CollinHeist/UIdaho-Team-FIRE/Final Presentation/PCB Layout.jpg

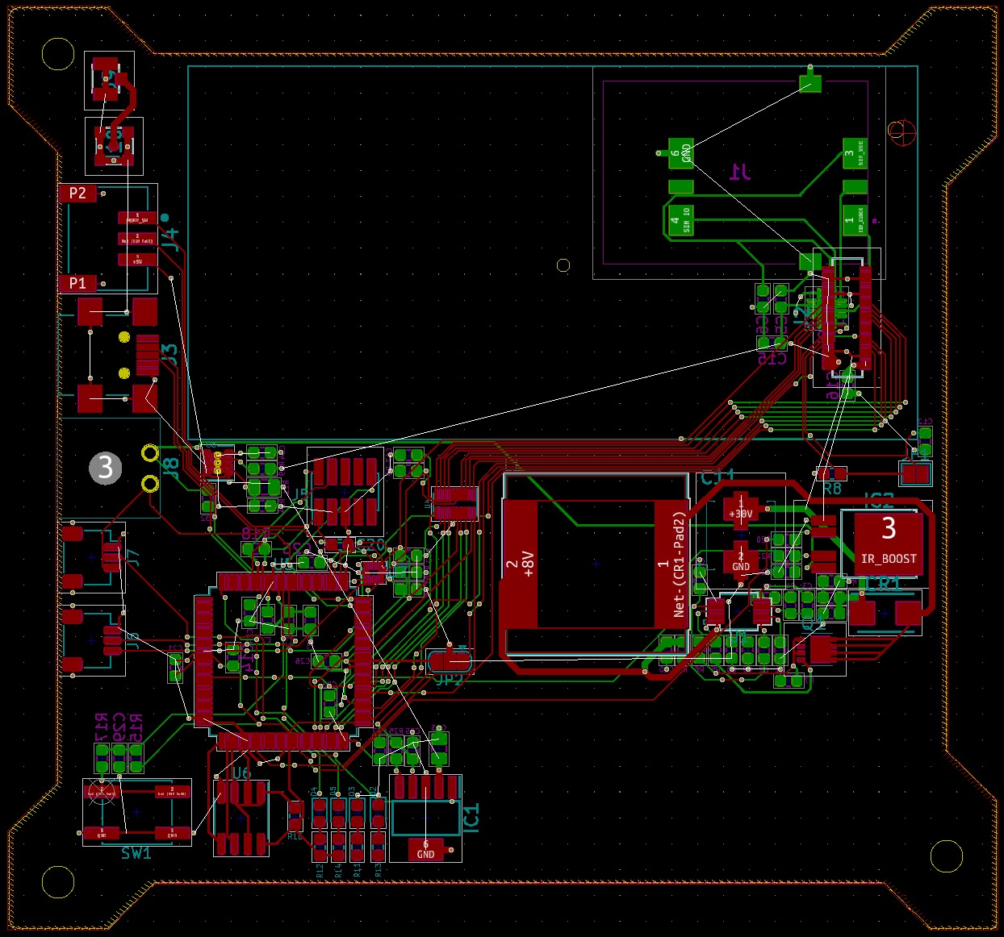
Final Presentation/PCB Layout.jpg
