CollinHeist/UIdaho-Team-FIRE/Final Presentation/3D PCB Back.png

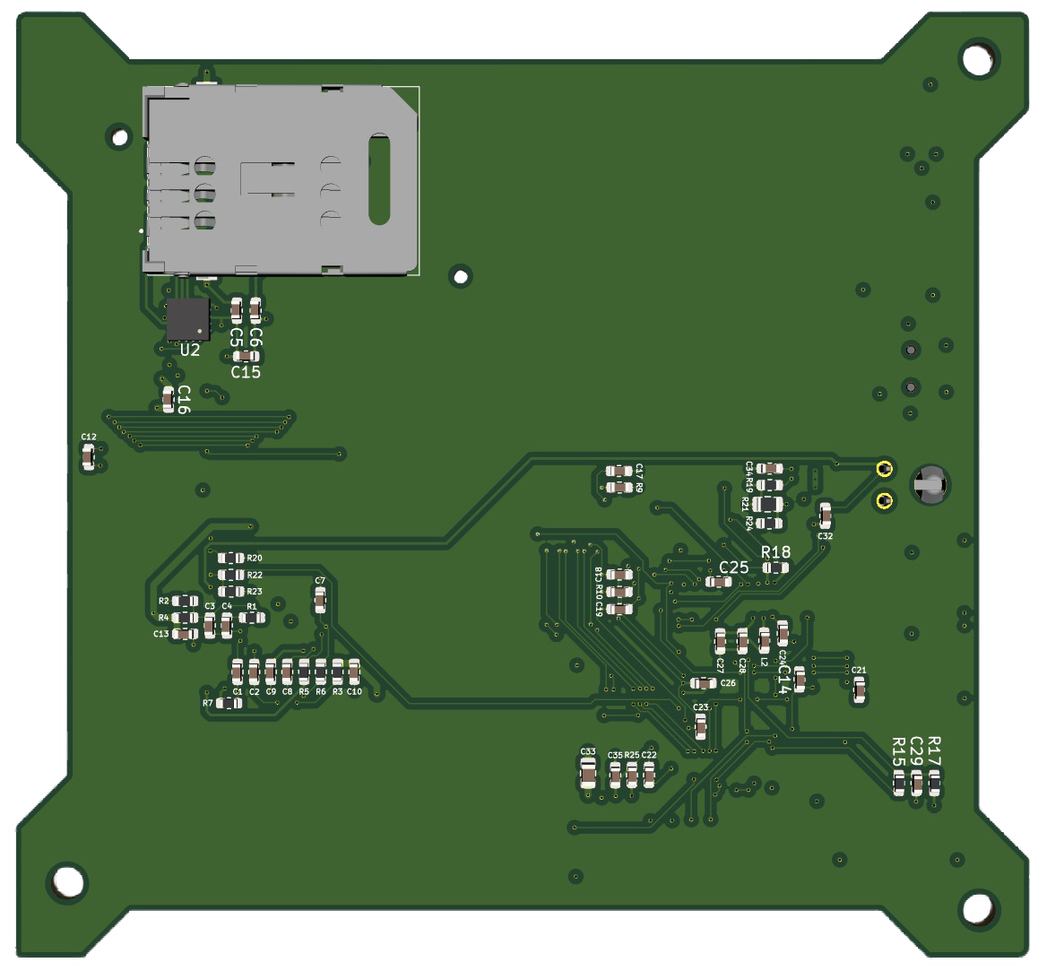
Final Presentation/3D PCB Back.png
