CollinHeist/UIdaho-Team-FIRE/Final Presentation/3D PCB Front.png

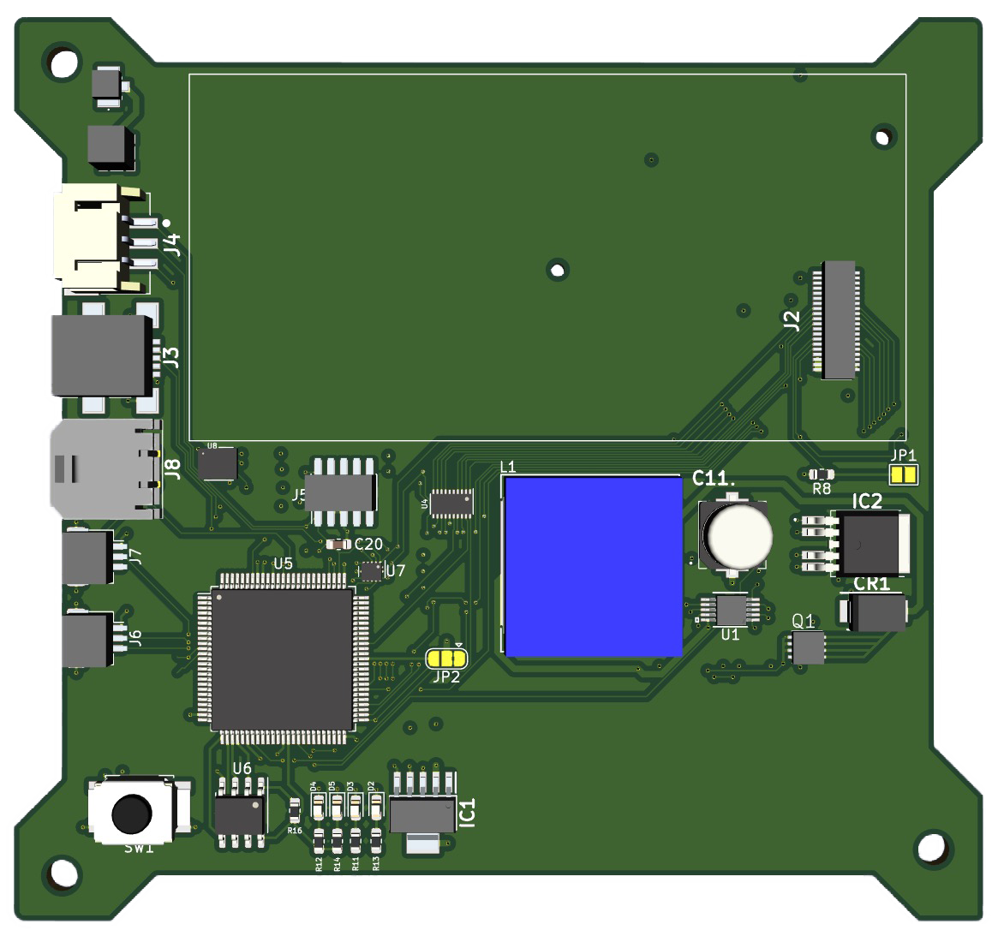
Final Presentation/3D PCB Front.png
