CollinHeist/UIdaho-Team-FIRE/Component Test Board/Board v2.0/Outputs/Board-transparent.png

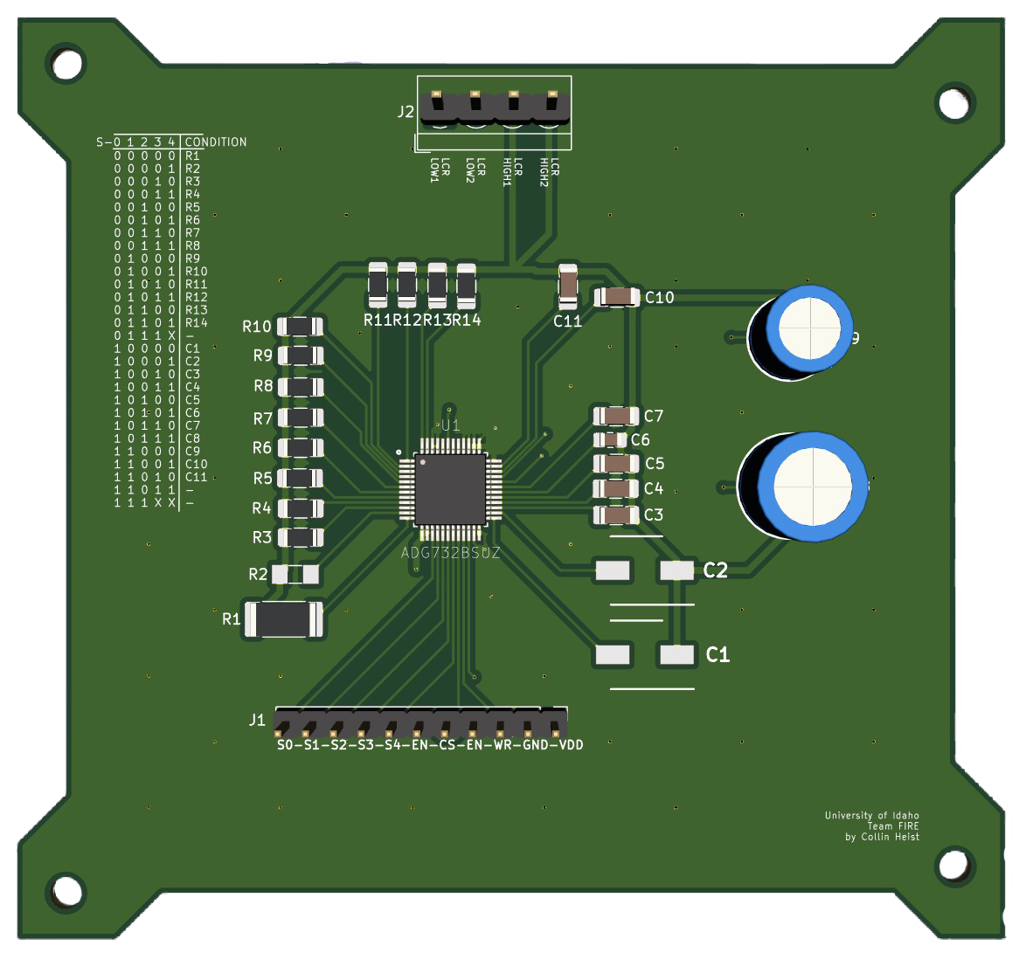
Component Test Board/Board v2.0/Outputs/Board-transparent.png
