CollinHeist/UIdaho-Team-FIRE/Final Presentation/3D Component Board.png

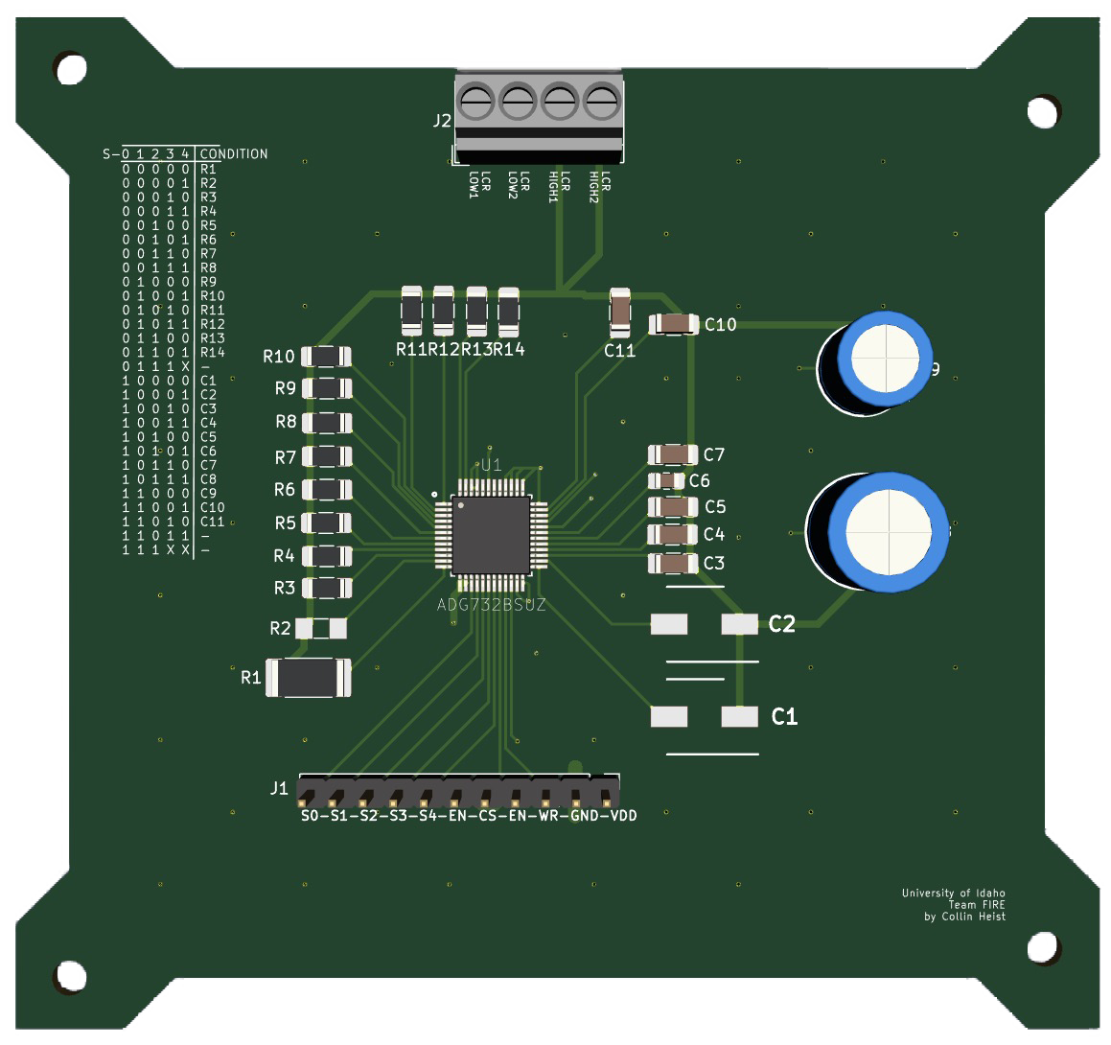
Final Presentation/3D Component Board.png
