CollinHeist/UIdaho-Team-FIRE/Final Presentation/Component Table.jpg

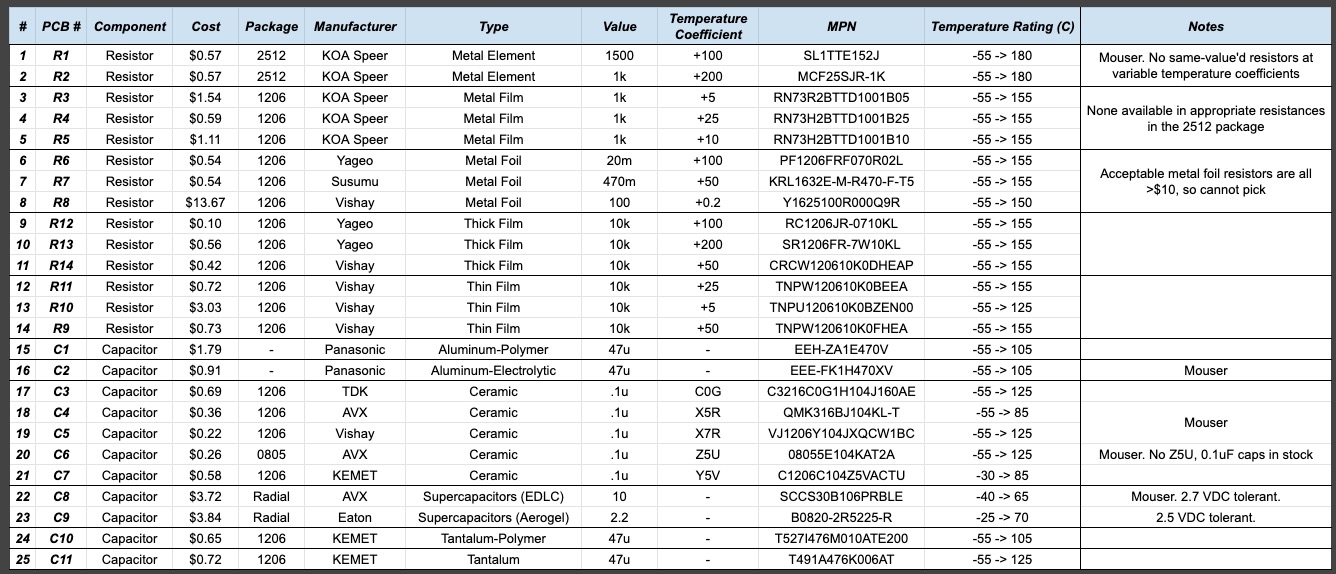
Final Presentation/Component Table.jpg
