CollinHeist/UIdaho-Team-FIRE/Board Redesign/KiCad Project/Team-FIRE-v2/B26013F/B260-13-F.stp

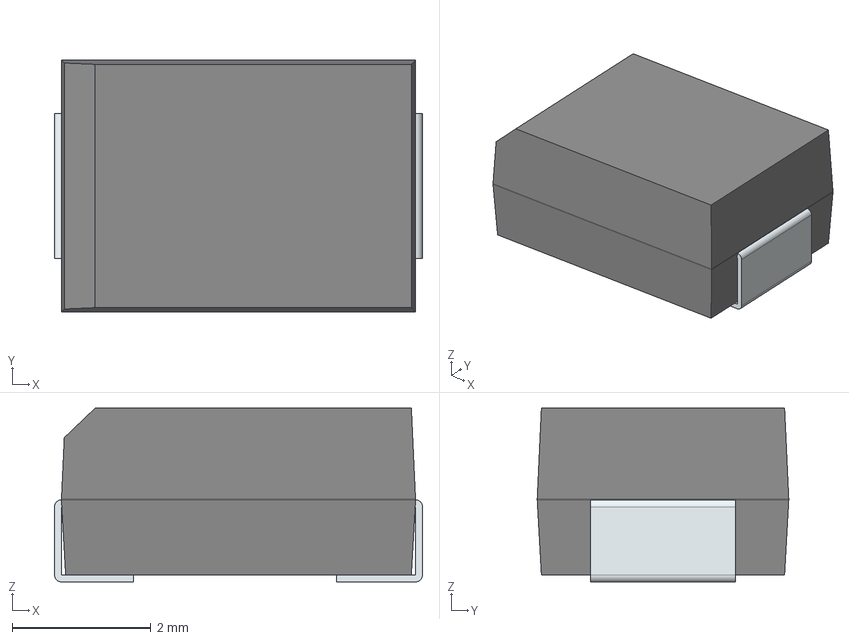
[picture p7: CAD file, 2020-05-06]
Board Redesign/KiCad Project/Team-FIRE-v2/B26013F/B260-13-F.stp
5.29 x 3.62 x 2.50 mm
FilletPin1
FilletPin2
