CollinHeist/UIdaho-Team-FIRE/Board Redesign/KiCad Project/Team-FIRE-v2/FTSH-105-01-L-DV-K-TR/FTSH-105-01-L-DV-K-TR.stp

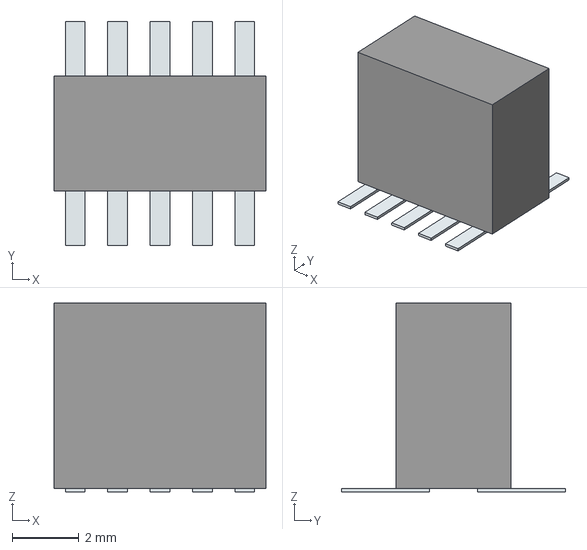
[picture p8: CAD file, 2020-05-07]
Board Redesign/KiCad Project/Team-FIRE-v2/FTSH-105-01-L-DV-K-TR/FTSH-105-01-L-DV-K-TR.stp
6.35 x 6.71 x 5.66 mm
Pins
