CollinHeist/UIdaho-Team-FIRE/Board Redesign/KiCad Project/Team-FIRE-v2/IHLP6767GZER220M11/IHLP6767GZER220M11.stp

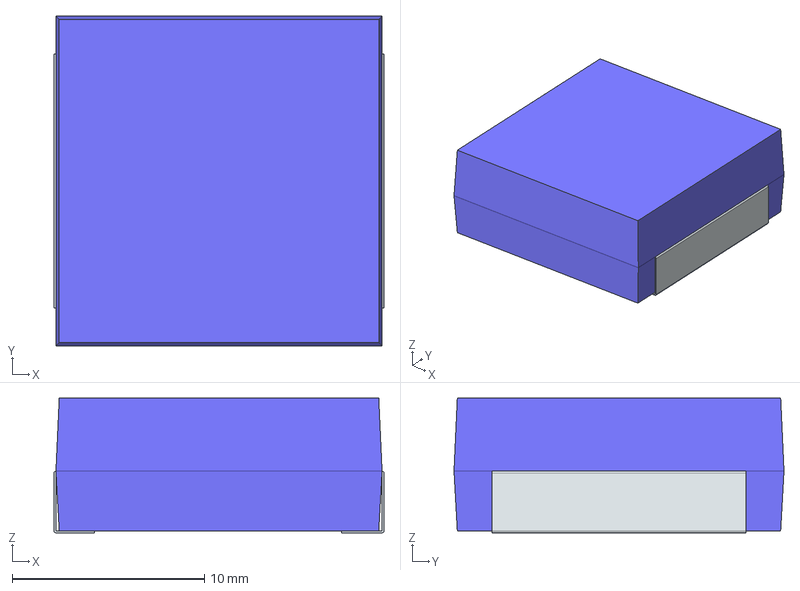
[picture p9: CAD file, 2020-05-07]
Board Redesign/KiCad Project/Team-FIRE-v2/IHLP6767GZER220M11/IHLP6767GZER220M11.stp
17.1 x 17.1 x 7.00 mm
FilletPin1
FilletPin2
