CollinHeist/UIdaho-Team-FIRE/Board Redesign/KiCad Project/Team-FIRE-v2/MCP1826T3302EDC/MCP1826T-3302E_DC.stp

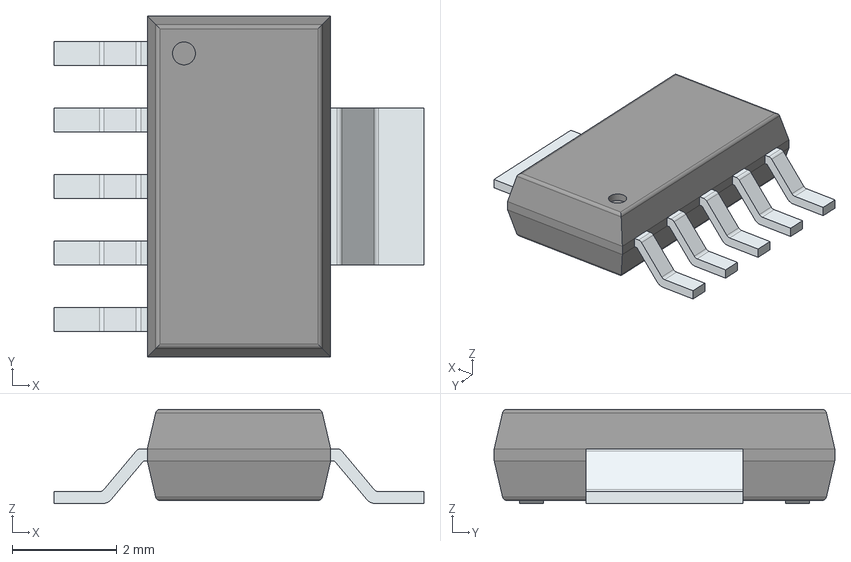
[picture p10: CAD file, 2020-04-29]
Board Redesign/KiCad Project/Team-FIRE-v2/MCP1826T3302EDC/MCP1826T-3302E_DC.stp
7.06 x 6.50 x 1.80 mm
PinsArrayL
FilletPinR
