CollinHeist/UIdaho-Team-FIRE/Board Redesign/KiCad Project/Team-FIRE-v2/S3B-PH-SM4-TB(LF)(SN)/S3B-PH-SM4-TB(LF)(SN).STEP

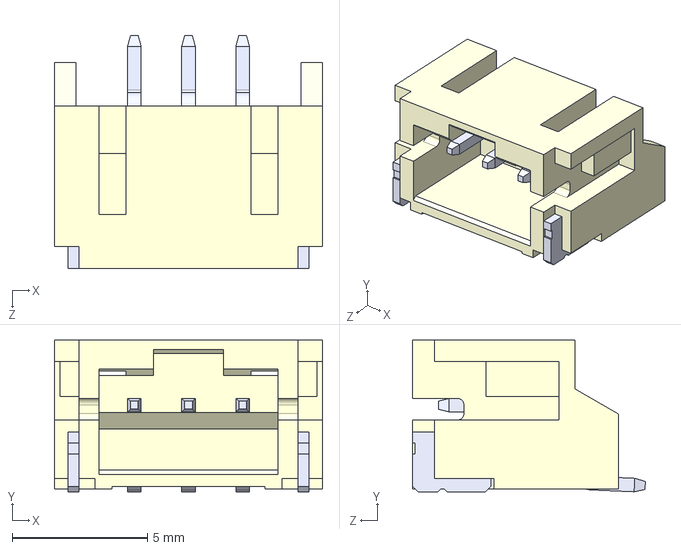
[picture p11: CAD file, 2020-05-07]
Board Redesign/KiCad Project/Team-FIRE-v2/S3B-PH-SM4-TB(LF)(SN)/S3B-PH-SM4-TB(LF)(SN).STEP
9.90 x 5.60 x 8.60 mm
