CollinHeist/UIdaho-Team-FIRE/Board Redesign/KiCad Project/Team-FIRE-v2/SM03B-SRSS-TB(LF)(SN)/SM03B-SRSS-TB_LF__SN_.stp

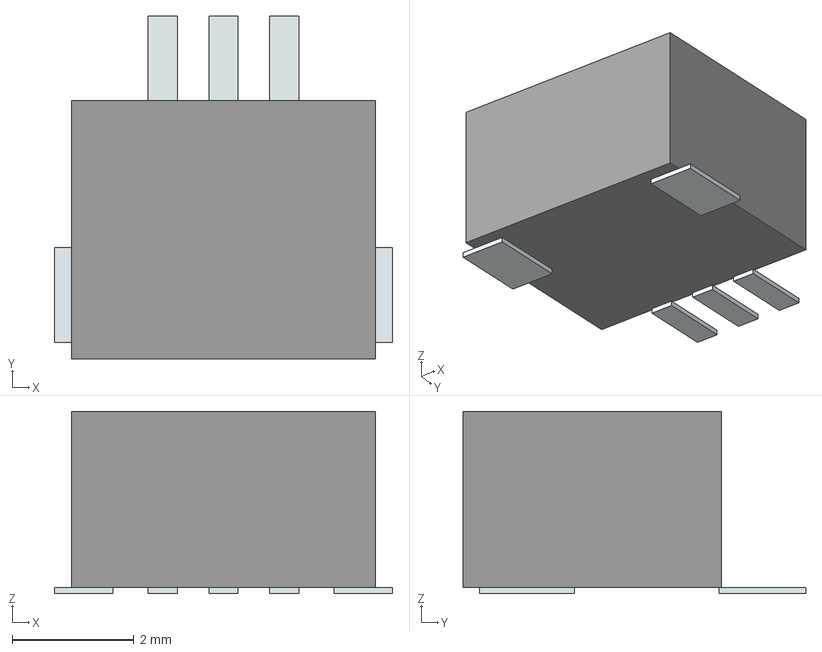
[picture p12: CAD file, 2020-05-07]
Board Redesign/KiCad Project/Team-FIRE-v2/SM03B-SRSS-TB(LF)(SN)/SM03B-SRSS-TB_LF__SN_.stp
5.56 x 5.64 x 3.00 mm
Pins
