CollinHeist/UIdaho-Team-FIRE/Board Redesign/KiCad Project/Team-FIRE-v2/UX60-MB-5ST/UX60-MB-5ST.stp

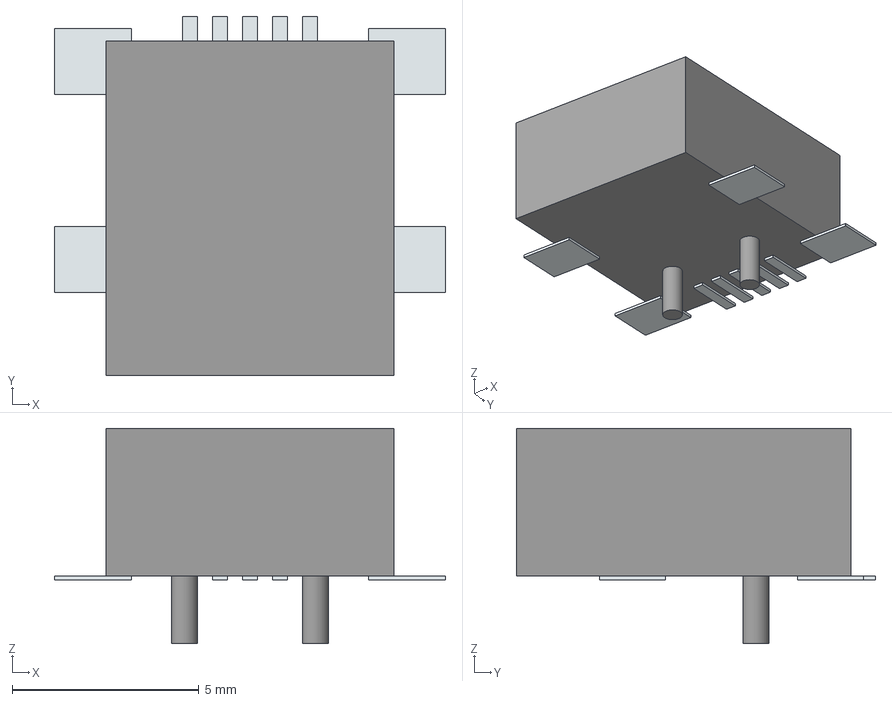
[picture p13: CAD file, 2020-04-30]
Board Redesign/KiCad Project/Team-FIRE-v2/UX60-MB-5ST/UX60-MB-5ST.stp
10.5 x 9.60 x 5.75 mm
Pins
Lugs x 2
