CollinHeist/UIdaho-Team-FIRE/Board Redesign/KiCad Project/Team-FIRE-v2/47388-2001/47388-2001.stp

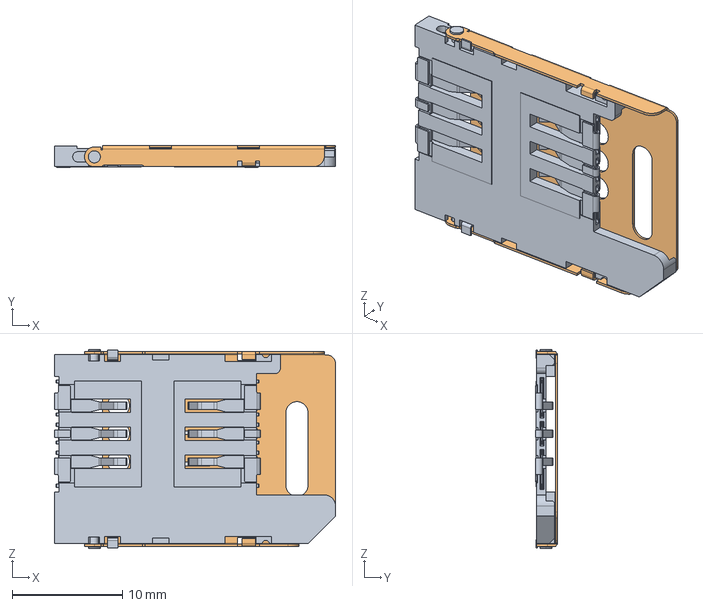
[picture p14: CAD file, 2020-05-06]
Board Redesign/KiCad Project/Team-FIRE-v2/47388-2001/47388-2001.stp
25.5 x 2.00 x 18.1 mm
