CollinHeist/UIdaho-Team-FIRE/Board Redesign/KiCad Project/Team-FIRE-v2/CSD18543Q3AT/CSD18543Q3AT.stp

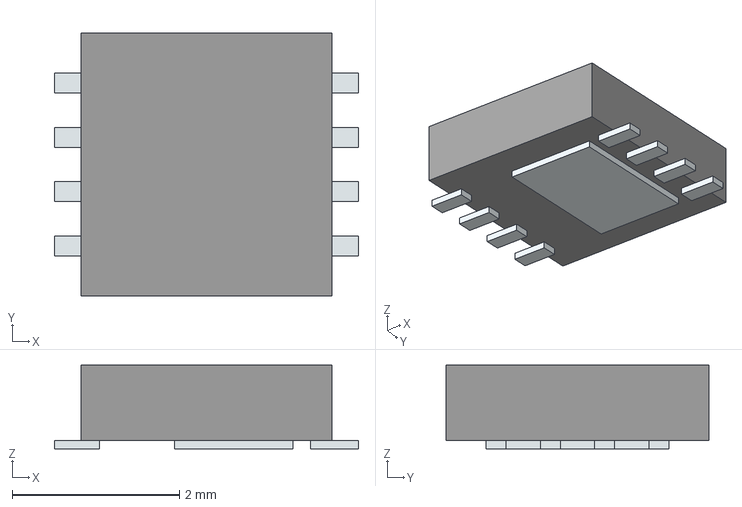
[picture p15: CAD file, 2020-05-06]
Board Redesign/KiCad Project/Team-FIRE-v2/CSD18543Q3AT/CSD18543Q3AT.stp
3.64 x 3.15 x 1.00 mm
Pins
