CollinHeist/UIdaho-Team-FIRE/Board Redesign/KiCad Project/Team-FIRE-v2/TPS40210DGQR/TPS40210DGQR.stp

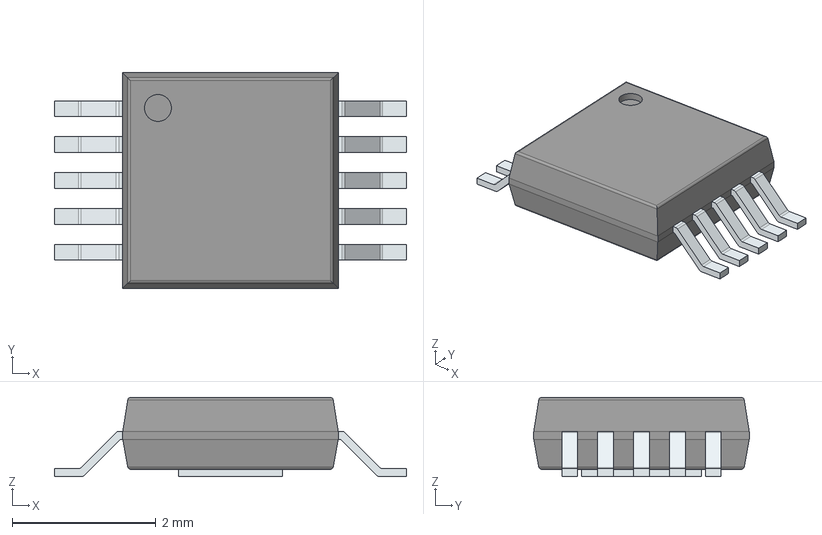
[picture p16: CAD file, 2020-05-07]
Board Redesign/KiCad Project/Team-FIRE-v2/TPS40210DGQR/TPS40210DGQR.stp
4.90 x 3.00 x 1.10 mm
PinsArrayLR
ThermalPad
