CollinHeist/UIdaho-Team-FIRE/Component Test Board/Board v2.0/393570004.stp

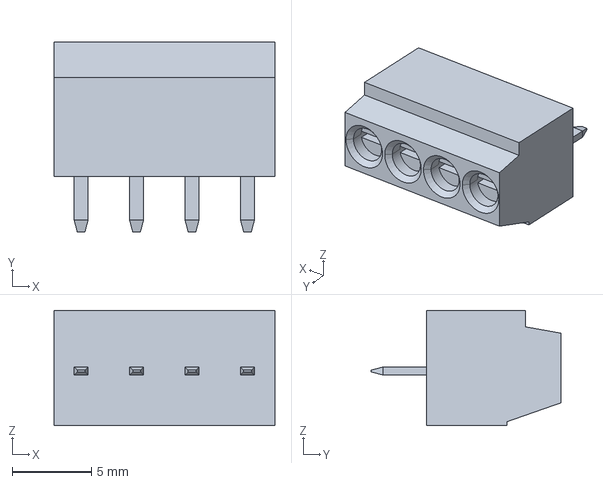
[picture p17: CAD file, 2020-05-07]
Component Test Board/Board v2.0/393570004.stp
14.0 x 12.0 x 7.29 mm
