CollinHeist/UIdaho-Team-FIRE/(list of files, cad)

Other CAD files:
Board Redesign/KiCad Project/Team-FIRE-v2/IHLP6767GZER220M11/IHLP6767GZER220M11.stl
