CollinHeist/UIdaho-Team-FIRE/Board Redesign/KiCad Project/Team-FIRE-v2/Team-FIRE-v2.kicad_pcb

## KiCad design Board Redesign/KiCad Project/Team-FIRE-v2/Team-FIRE-v2.kicad_pcb (2020-05-27)

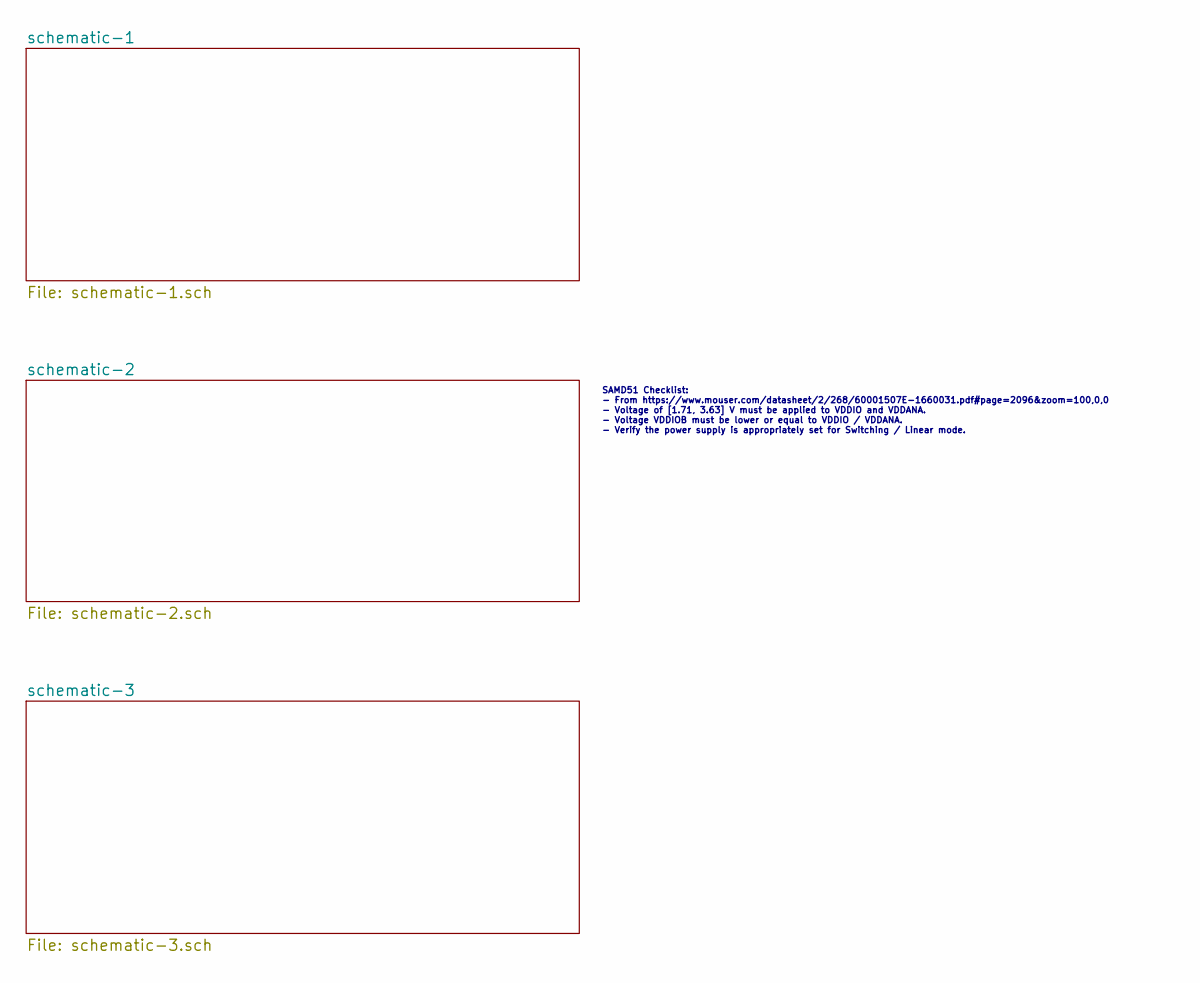
[picture p18: schematic Team-FIRE-v2.sch, Team FIRE Board Redesign]

Notes on the sheet:
SAMD51 Checklist: - From https://www.mouser.com/datasheet/2/268/60001507E-1660031.pdf#page=2096&zoom=100,0,0 - Voltage of [1.71, 3.63] V must be applied to VDDIO and VDDANA. - Voltage VDDIOB must be lower or equal to VDDIO / VDDANA. - Verify the power supply is appropriately set for Switching / Lin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

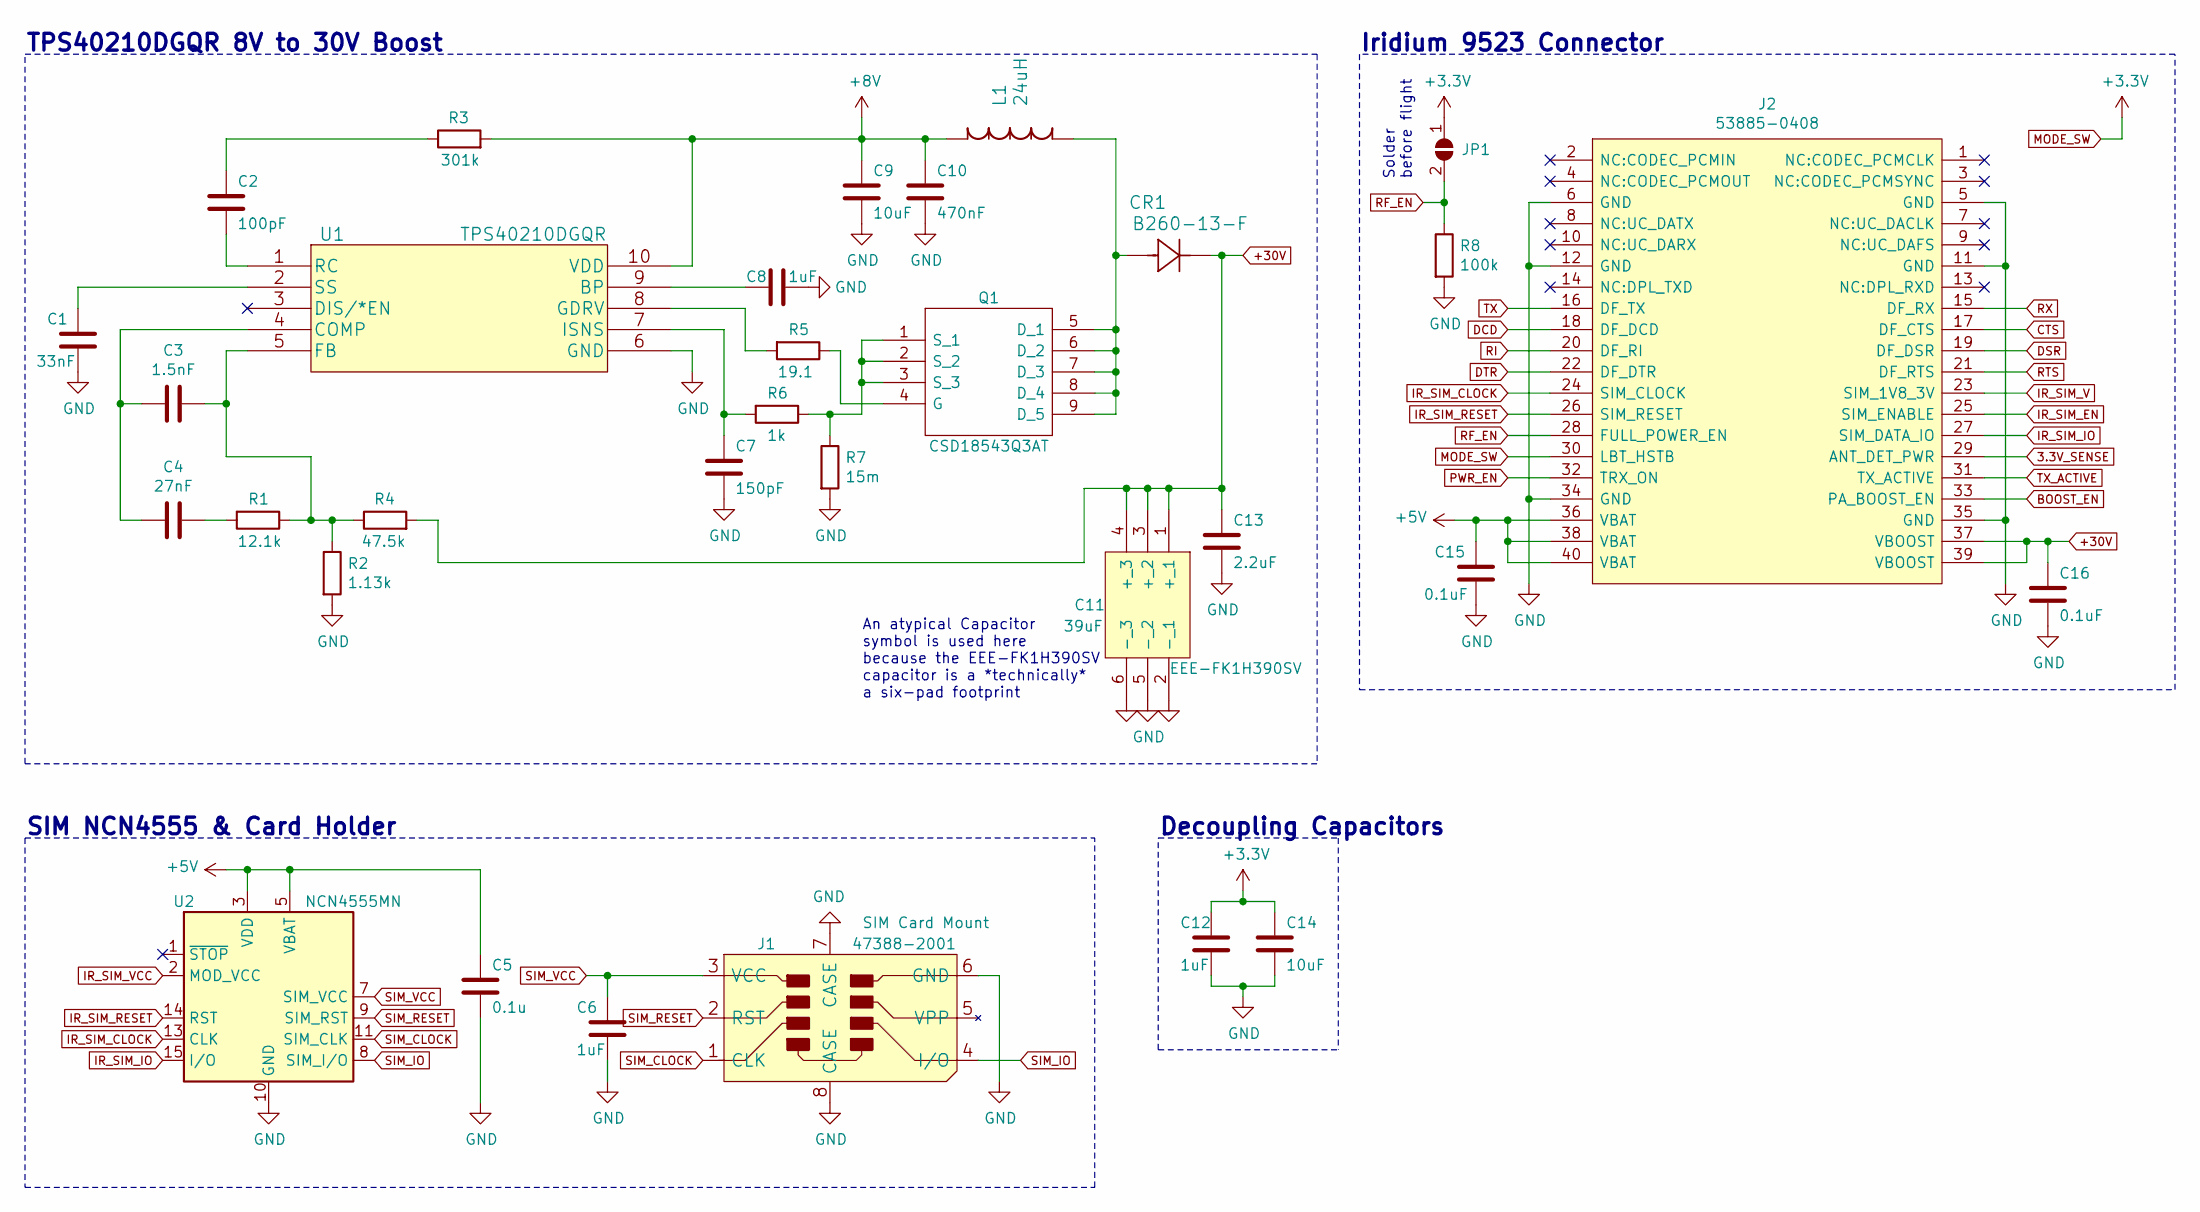
[picture p19: schematic schematic-1.sch, Team FIRE Flight-Ready Iridium Carrier]

Parts:
C1: 33nF; C_0603_1608Metric; Tolerance 5%; Voltage Rating 100 VDC; MPN C0603C333J1RECTU
C2: 100pF; C_0603_1608Metric; Tolerance 1%; Voltage Rating 50 VDC; MPN CBR06C101F5GAC
C3: 1.5nF; C_0603_1608Metric; Tolerance 5%; Voltage Rating 100 VDC; MPN C1608C0G2A152J080AE
C4: 27nF; C_0603_1608Metric; Tolerance 5%; Voltage Rating 25 VDC; MPN C0603C273J3RACTU
C5: 0.1u; C_0603_1608Metric; Tolerance 10%; Voltage Rating 50 VDC; MPN C0603C104K5RAC3121
C6, C12: 1uF; C_0603_1608Metric; Tolerance 10%; Voltage Rating 25 VDC; MPN TMK107BLD105KA-T
C7: 150pF; C_0603_1608Metric
C8: 1uF; C_0603_1608Metric
C9, C14: 10uF; C_0603_1608Metric; Tolerance 10%; Voltage Rating 25 VDC; MPN GRM188R61E106KA73D
C10: 470nF; C_0603_1608Metric; Tolerance 5%; Voltage Rating 16 VDC; MPN C0603C474J4RACAUTO
C11: 39uF; EEEFK1H390SV; Tolerance 20%; Voltage Rating 50 VDC; MPN EEE-FK1H390SV
C13: 2.2uF; C_0603_1608Metric; Voltage Rating 50 VDC; MPN GRM188R61H225KE11D
C15, C16: 0.1uF; C_0603_1608Metric; Tolerance 10%; Voltage Rating 50 VDC; MPN C0603C104K5RAC3121
CR1: B260-13-F; DIOM5336X250N; Voltage Rating 60 V; Current Rating 2 A; MPN B260-13-F
J1: 47388-2001; 473882001; Current Rating 500 mA; MPN 47388-2001
J2: 53885-0408; 538850408; Mouser Part Number 538-53885-0408
JP1: SolderJumper_2_Open; SolderJumper-2_P1.3mm_Open_Pad1.0x1.5mm
L1: 24uH; IHLP6767GZER220M11; Tolerance 20%; Current Rating 12 A; MPN IHLP6767GZER220M11
Q1: CSD18543Q3AT; MPN CSD18543Q3AT
R1: 12.1k; R_0603_1608Metric; Tolerance 0.1%; MPN ERJ-PB3B1212V
R2: 1.13k; R_0603_1608Metric; Tolerance 0.1%; MPN RQ73C1J1K13BTDF
R3: 301k; R_0603_1608Metric; Voltage Rating 75 V; Tolerance 1%; MPN CRCW0603301KFKEAHP
R4: 47.5k; R_0603_1608Metric; Tolerance 1%; Voltage Rating 75 V; MPN MCT06030C4752FP500
R5: 19.1; R_0603_1608Metric; Tolerance 1%; Voltage Rating 75 V; MPN ERJ-3EKF19R1V
R6: 1k; R_0603_1608Metric; Tolerance 0.1%; Voltage Rating 75 V; MPN MCT0603MD1001BP500
R7: 15m; R_0603_1608Metric; Tolerance 1%; MPN LVT06R0150FER
R8: 100k; R_0603_1608Metric; Tolerance 0.1%; Voltage Rating 75 V; MPN MCT06030E1003BP500
U1: TPS40210DGQR; MPN TPS40210DGQR
U2: NCN4555MN; QFN-16-1EP_3x3mm_P0.5mm_EP1.75x1.75mm; MPN NCN4555MNR2G

Connections:
3.3V_SENSE: J2.29 (ANT_DET_PWR); also elsewhere on the board
+5V: C5.1, C15.1, J2.36 (VBAT), J2.38 (VBAT), J2.40 (VBAT), U2.3 (VDD), U2.5 (VBAT); also elsewhere on the board
+8V: C9.1, C10.1, L1.2, R3.2, U1.10 (VDD)
+30V: C11.1 (+_1), C11.3 (+_2), C11.4 (+_3), C13.1, C16.1, CR1.1, J2.37 (VBOOST), J2.39 (VBOOST), R4.2
BOOST_EN: J2.33 (PA_BOOST_EN); also elsewhere on the board
CTS: J2.17 (DF_CTS); also elsewhere on the board
DCD: J2.18 (DF_DCD); also elsewhere on the board
DSR: J2.19 (DF_DSR); also elsewhere on the board
DTR: J2.22 (DF_DTR); also elsewhere on the board
GND: C1.2, C5.2, C6.2, C7.2, C8.1, C9.2, C10.2, C11.2 (-_1), C11.5 (-_2), C11.6 (-_3), C12.2, C13.2, C14.2, C15.2, C16.2, J1.6 (GND), J1.7 (CASE), J1.8 (CASE), J2.5 (GND), J2.6 (GND), J2.11 (GND), J2.12 (GND), J2.34 (GND), J2.35 (GND), R2.2, R7.2, R8.2, U1.6 (GND), U2.10 (GND), U2.17 (GND); also elsewhere on the board
IR_SIM_CLOCK: J2.24 (SIM_CLOCK), U2.13 (CLK)
IR_SIM_EN: J2.25 (SIM_ENABLE)
IR_SIM_IO: J2.27 (SIM_DATA_IO), U2.15 (I/O)
IR_SIM_RESET: J2.26 (SIM_RESET), U2.14 (RST)
IR_SIM_V: J2.23 (SIM_1V8_3V)
IR_SIM_VCC: U2.2 (MOD_VCC)
MODE_SW: C12.1, C14.1, J2.30 (LBT_HSTB), JP1.1 (A); also elsewhere on the board
unnamed: C1.1, U1.2 (SS)
unnamed: C2.1, R3.1
unnamed: C2.2, U1.1 (RC)
unnamed: C3.1, R1.1, R2.1, R4.1, U1.5 (FB)
unnamed: C3.2, C4.2, U1.4 (COMP)
unnamed: C4.1, R1.2
unnamed: C7.1, R6.2, U1.7 (ISNS)
unnamed: C8.2, U1.9 (BP)
unnamed: CR1.2, L1.1, Q1.5 (D_1), Q1.6 (D_2), Q1.7 (D_3), Q1.8 (D_4), Q1.9 (D_5)
unnamed: Q1.1 (S_1), Q1.2 (S_2), Q1.3 (S_3), R6.1, R7.1
unnamed: Q1.4 (G), R5.1
unnamed: R5.2, U1.8 (GDRV)
PWR_EN: J2.32 (TRX_ON); also elsewhere on the board
RF_EN: J2.28 (FULL_POWER_EN), JP1.2 (B), R8.1
RI: J2.20 (DF_RI); also elsewhere on the board
RTS: J2.21 (DF_RTS); also elsewhere on the board
RX: J2.15 (DF_RX); also elsewhere on the board
SIM_CLOCK: J1.1 (CLK), U2.11 (SIM_CLK)
SIM_IO: J1.4 (I/O), U2.8 (SIM_I/O)
SIM_RESET: J1.2 (RST), U2.9 (SIM_RST)
SIM_VCC: C6.1, J1.3 (VCC), U2.7 (SIM_VCC)
TX: J2.16 (DF_TX); also elsewhere on the board
TX_ACTIVE: J2.31 (TX_ACTIVE); also elsewhere on the board

Notes on the sheet:
Iridium 9523 Connector
SIM NCN4555 & Card Holder
Solder before flight
Decoupling Capacitors
TPS40210DGQR 8V to 30V Boost
An atypical Capacitor symbol is used here because the EEE-FK1H390SV capacitor is a *technically* a six-pad footprint

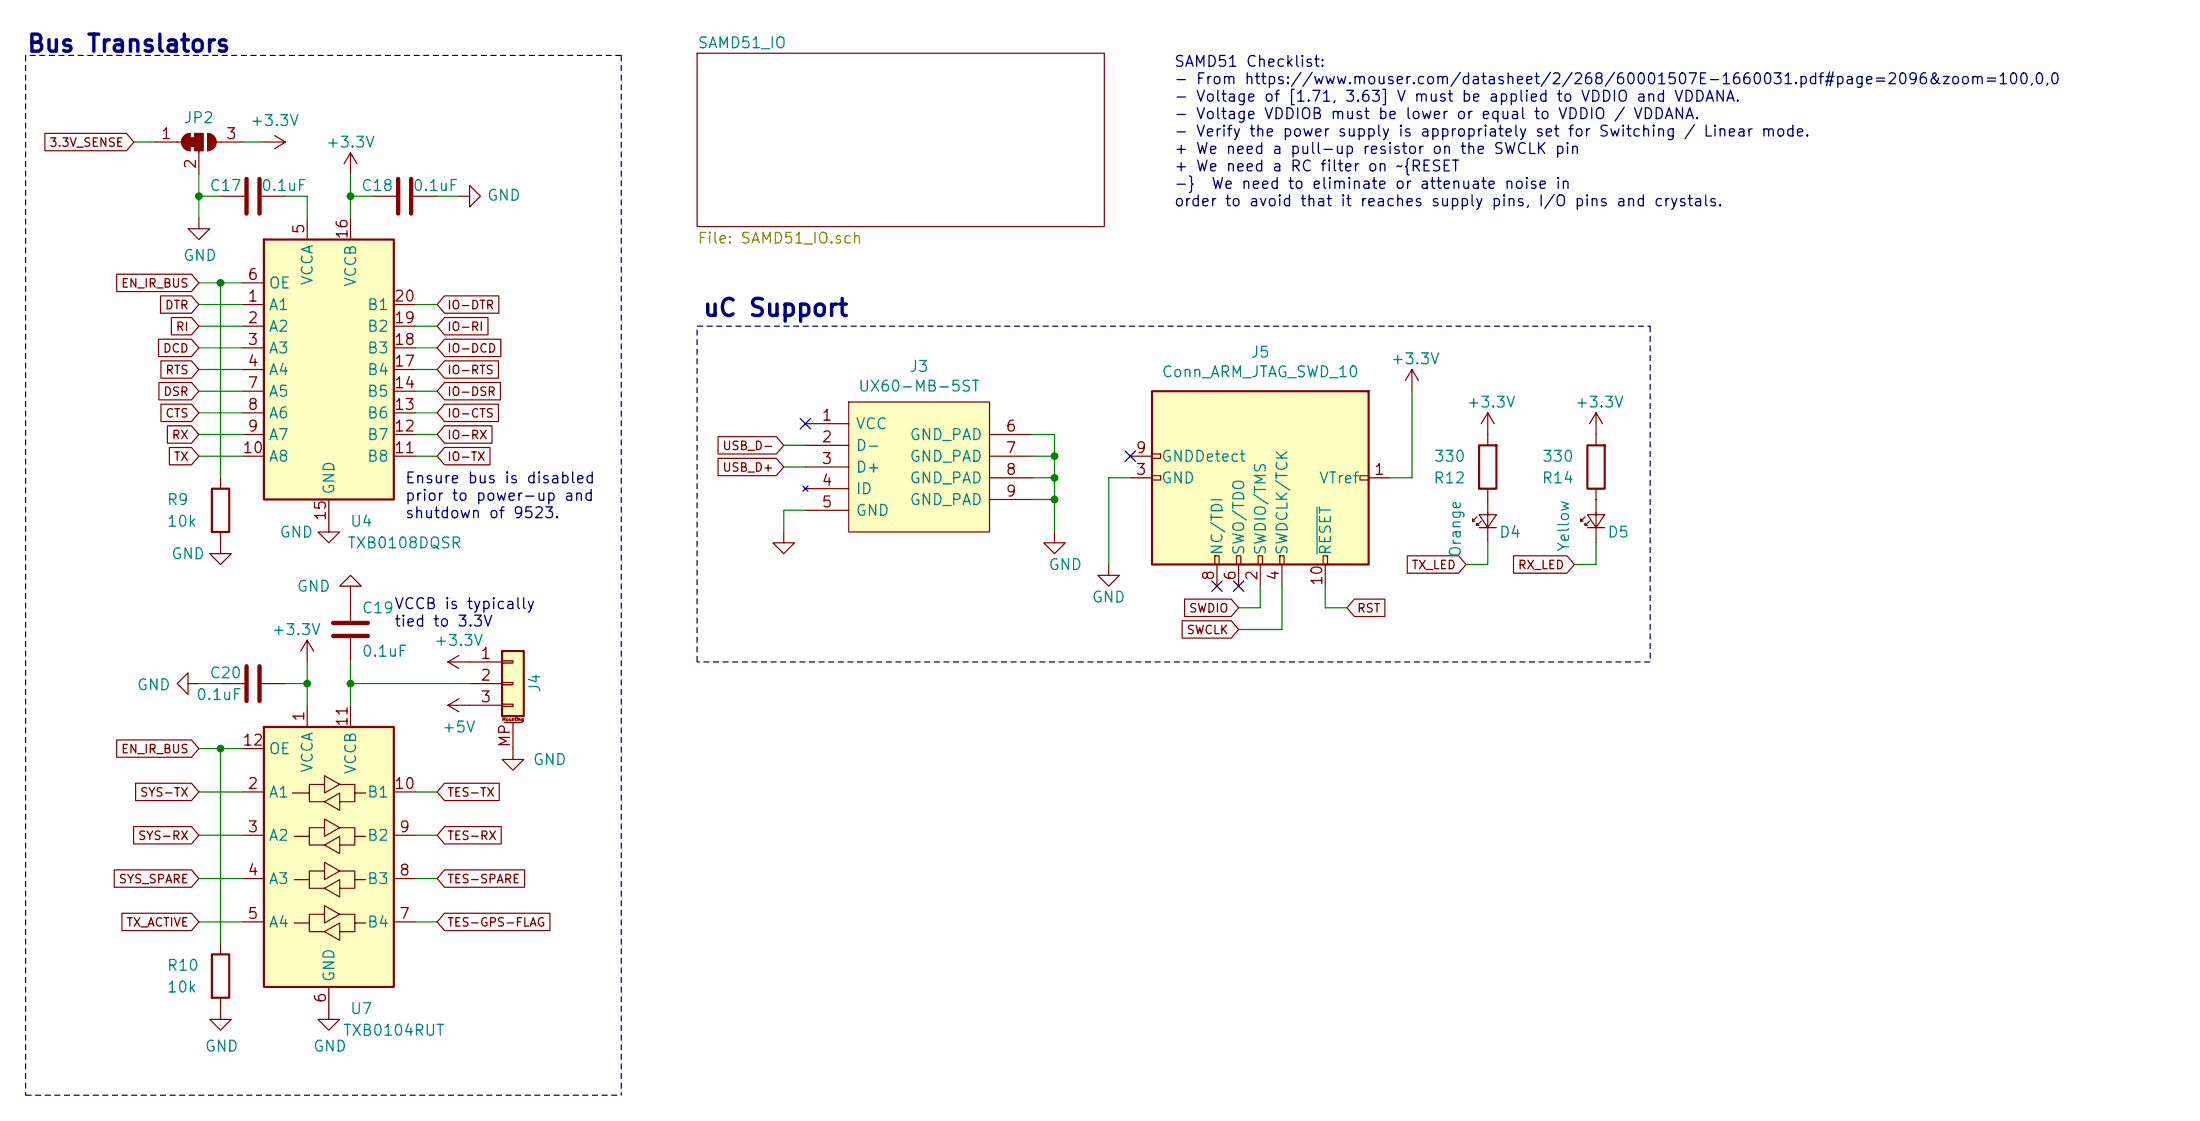
[picture p20: schematic schematic-2.sch, Team FIRE Flight-Ready Iridium Carrier]

Parts:
C17, C18, C19, C20: 0.1uF; C_0603_1608Metric; Tolerance 10%; Voltage Rating 50 VDC; MPN C0603C104K5RAC3121
D4: Orange; LED_0603_1608Metric; MPN KO DELLS1.22-KHLI-24
D5: Yellow; LED_0603_1608Metric; MPN KY DELLS1.22-KGLH-26
J3: UX60-MB-5ST; HIROSE-UX60-MB-5ST; MPN UX60-MB-5ST
J4: Conn_01x03; JST_S3B-PH-SM4-TB(LF)(SN); Voltage Rating 100 V; Current Rating 2 A; MPN S3B-PH-SM4-TB(LF)(SN)
J5: Conn_ARM_JTAG_SWD_10; PinHeader_2x05_P1.27mm_Vertical_SMD; Current Rating 3.4 A per contact; MPN FTSH-105-01-L-DV-K-TR
JP2: SolderJumper_3_Bridged12; SolderJumper-3_P1.3mm_Bridged2Bar12_RoundedPad1.0x1.5mm
R9, R10: 10k; R_0603_1608Metric; Tolerance 0.1%; Voltage Rating 75 V; MPN MCT06030E1002BP100
R12, R14: 330; R_0603_1608Metric; Tolerance 1%; Voltage Rating 75 V; MPN SR0603FR-7T330RL
U4: TXB0108DQSR; USON-20_2x4mm_P0.4mm; Voltage Rating 1.2/1.65 V to 5.5 V
U7: TXB0104RUT; Texas_R_PUQFN-N12; Voltage Rating 1.2/1.65 V to 5.5 V; MPN TXB0104RUTR

Connections:
3.3V_SENSE: JP2.1 (A); also elsewhere on the board
+5V: J4.3; also elsewhere on the board
CTS: U4.8 (A6); also elsewhere on the board
DCD: U4.3 (A3); also elsewhere on the board
DSR: U4.7 (A5); also elsewhere on the board
DTR: U4.1 (A1); also elsewhere on the board
EN_IR_BUS: R9.1, R10.1, U4.6 (OE), U7.12 (OE); also elsewhere on the board
GND: C17.1, C18.2, C19.1, C20.1, J3.5 (GND), J3.6 (GND_PAD), J3.7 (GND_PAD), J3.8 (GND_PAD), J3.9 (GND_PAD), J4.MP (MountPin), J5.3 (GND), J5.5 (GND), JP2.2 (C), R9.2, R10.2, U4.15 (GND), U7.6 (GND); also elsewhere on the board
IO-CTS: U4.13 (B6); also elsewhere on the board
IO-DCD: U4.18 (B3); also elsewhere on the board
IO-DSR: U4.14 (B5); also elsewhere on the board
IO-DTR: U4.20 (B1); also elsewhere on the board
IO-RI: U4.19 (B2); also elsewhere on the board
IO-RTS: U4.17 (B4); also elsewhere on the board
IO-RX: U4.12 (B7); also elsewhere on the board
IO-TX: U4.11 (B8); also elsewhere on the board
MODE_SW: C18.1, C20.2, J4.1, J5.1 (VTref), JP2.3 (B), R12.2, R14.2, U4.16 (VCCB), U7.1 (VCCA); also elsewhere on the board
unnamed: C17.2, U4.5 (VCCA)
unnamed: C19.2, J4.2, U7.11 (VCCB)
unnamed: D4.2 (A), R12.1
unnamed: D5.2 (A), R14.1
RI: U4.2 (A2); also elsewhere on the board
RST: J5.10 (~RESET~); also elsewhere on the board
RTS: U4.4 (A4); also elsewhere on the board
RX: U4.9 (A7); also elsewhere on the board
RX_LED: D5.1 (K); also elsewhere on the board
SWCLK: J5.4 (SWDCLK/TCK); also elsewhere on the board
SWDIO: J5.2 (SWDIO/TMS); also elsewhere on the board
SYS-RX: U7.3 (A2); also elsewhere on the board
SYS-TX: U7.2 (A1); also elsewhere on the board
SYS_SPARE: U7.4 (A3)
TES-GPS-FLAG: U7.7 (B4); also elsewhere on the board
TES-RX: U7.9 (B2); also elsewhere on the board
TES-SPARE: U7.8 (B3)
TES-TX: U7.10 (B1); also elsewhere on the board
TX: U4.10 (A8); also elsewhere on the board
TX_ACTIVE: U7.5 (A4); also elsewhere on the board
TX_LED: D4.1 (K); also elsewhere on the board
USB_D+: J3.3 (D+); also elsewhere on the board
USB_D-: J3.2 (D-); also elsewhere on the board

Notes on the sheet:
uC Support
SAMD51 Checklist: - From https://www.mouser.com/datasheet/2/268/60001507E-1660031.pdf#page=2096&zoom=100,0,0 - Voltage of [1.71, 3.63] V must be applied to VDDIO and VDDANA. - Voltage VDDIOB must be lower or equal to VDDIO / VDDANA. - Verify the power supply is appropriately set for Switching / Lin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
VCCB is typically tied to 3.3V
Ensure bus is disabled prior to power-up and shutdown of 9523.
Bus Translators

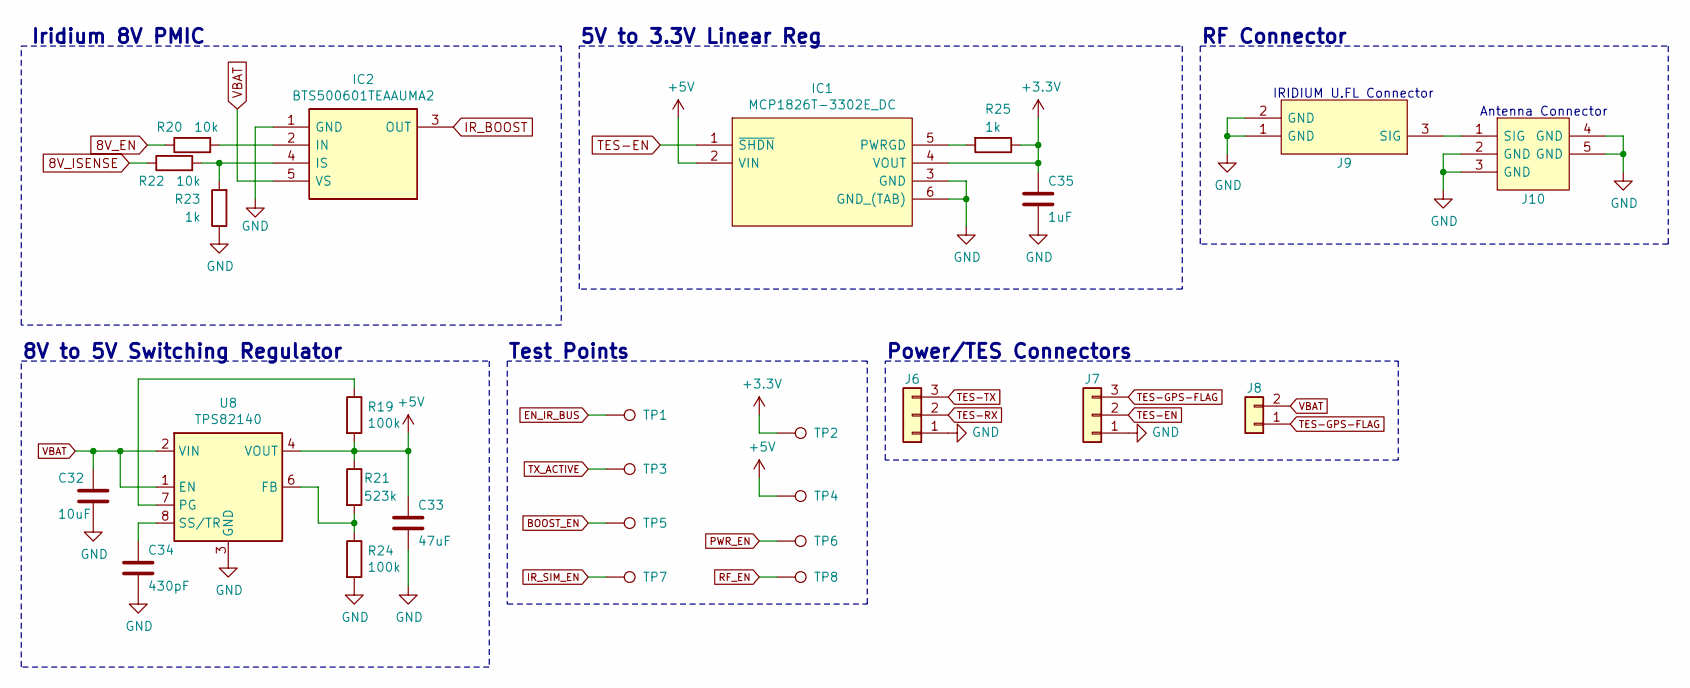
[picture p21: schematic schematic-3.sch, Team FIRE Flight-Ready Iridium Carrier]

Parts:
C32: 10uF; C_0603_1608Metric; Tolerance 10%; Voltage Rating 25 VDC; MPN GRM188R61E106KA73D
C33: 47uF; C_0805_2012Metric; Tolerance 20%; Voltage Rating 6.3 VDC; MPN JMK107BBJ476MA-RE
C34: 430pF; C_0603_1608Metric; Tolerance 5%; Voltage Rating 50 VDC; MPN 06035C431JAT2A
C35: 1uF; C_0603_1608Metric; Tolerance 10%; Voltage Rating 25 VDC; MPN TMK107BLD105KA-T
IC1: MCP1826T-3302E_DC; SOT127P706X180-6N; MPN MCP1826T-3302E/DC
IC2: BTS500601TEAAUMA2; MPN BTS500601TEAAUMA2
J6, J7: Conn_01x03; JST_SH_SM03B-SRSS-TB_1x03-1MP_P1.00mm_Horizontal; MPN SM03B-SRSS-TB(LF)(SN)
J8: Conn_01x02; 43650-0200; MPN 43650-0200
J9: U.FL-R-SMT_10_; UFLRSMT10; MPN U.FL-R-SMT(10)
J10: PCB.MMCX.F.ST.SMT.JACK.HT; PCBMMCXFSTSMTJACKHT; MPN PCB.MMCX.F.ST.SMT.JACK.HT
R19, R24: 100k; R_0603_1608Metric; Tolerance 0.1%; Voltage Rating 75 V; MPN MCT06030E1003BP500
R20, R22: 10k; R_0603_1608Metric; Tolerance 0.1%; Voltage Rating 75 V; MPN MCT06030E1002BP100
R21: 523k; R_0805_2012Metric; Tolerance 0.5%; Voltage Ratign 150 V; MPN ERJ-PB6D5233V
R23, R25: 1k; R_0603_1608Metric; Tolerance 0.1%; Voltage Rating 75 V; MPN MCT0603MD1001BP500
TP1, TP2, TP3, TP4, TP5, TP6, TP7, TP8: TestPoint; TestPoint_Pad_D1.0mm
U8: TPS82140; Texas_SIL0008D_MicroSiP-8-1EP_2.8x3mm_P0.65mm_EP1.1x1.9mm_T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; Voltage Rating 3 to 17 V; Current Rating 2 A; MPN TPS82140SILR

Connections:
8V_EN: R20.1; also elsewhere on the board
8V_ISENSE: R22.1; also elsewhere on the board
+5V: C33.1, IC1.2 (VIN), R19.2, R21.1, TP4.1, U8.4 (VOUT), U8.5 (VOUT); also elsewhere on the board
GND: C32.2, C33.2, C34.2, C35.2, IC1.3 (GND), IC1.6 (GND_(TAB)), IC2.1 (GND), J6.1, J7.1, J9.1 (GND), J9.2 (GND), J10.2 (GND), J10.3 (GND), J10.4 (GND), J10.5 (GND), R23.1, R24.2, U8.3 (GND), U8.9 (GND); also elsewhere on the board
IR_BOOST: IC2.3 (OUT)
MODE_SW: C35.1, IC1.4 (VOUT), R25.1, TP2.1; also elsewhere on the board
unnamed: C34.1, U8.8 (SS/TR)
unnamed: IC1.5 (PWRGD), R25.2
unnamed: IC2.2 (IN), R20.2
unnamed: IC2.4 (IS), R22.2, R23.2
unnamed: J9.3 (SIG), J10.1 (SIG)
unnamed: R19.1, U8.7 (PG)
unnamed: R21.2, R24.1, U8.6 (FB)
TES-EN: IC1.1 (~SHDN), J7.2
TES-GPS-FLAG: J7.3, J8.1; also elsewhere on the board
TES-RX: J6.2; also elsewhere on the board
TES-TX: J6.3; also elsewhere on the board
VBAT: C32.1, IC2.5 (VS), J8.2, U8.1 (EN), U8.2 (VIN)

Notes on the sheet:
RF Connector
Test Points
Iridium 8V PMIC
5V to 3.3V Linear Reg
IRIDIUM U.FL Connector
Antenna Connector
8V to 5V Switching Regulator
Power/TES Connectors

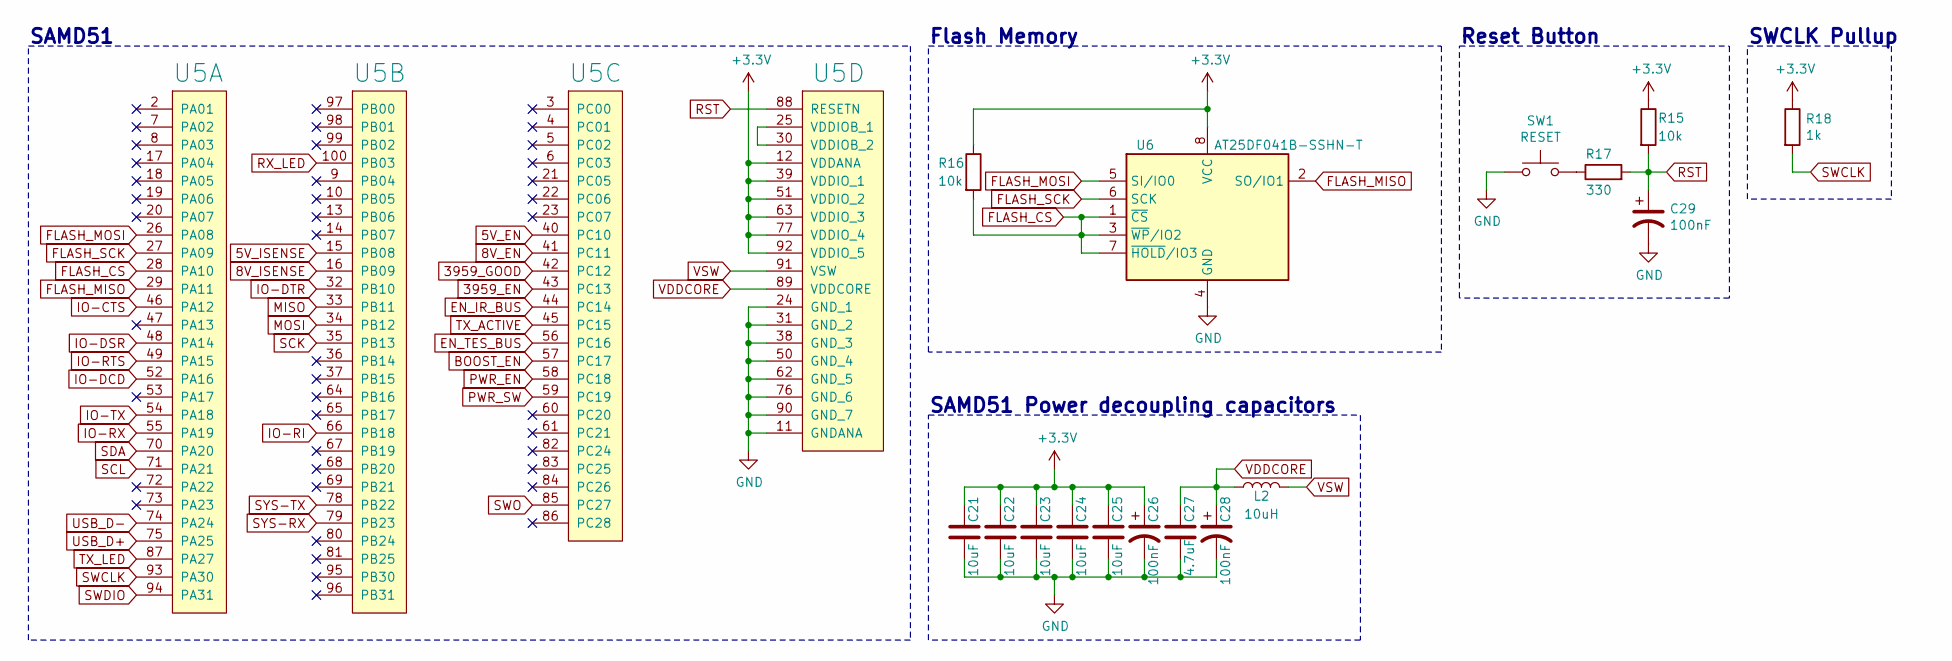
[picture p22: schematic SAMD51_IO.sch]

Parts:
C21, C22, C23, C24, C25: 10uF; C_0603_1608Metric; Tolerance 10%; Voltage Rating 25 VDC; MPN GRM188R61E106KA73D
C26, C28, C29: 100nF; C_0603_1608Metric; Tolerance 10%; Voltage Rating 50 VDC; MPN C0603X104K5RAC3316
C27: 4.7uF; C_0603_1608Metric; Tolerance 10%; Voltage Rating 35 VDC; MPN GMK107BBJ475KA-T
L2: 10uH; L_0603_1608Metric; Tolerance 20%; Current Rating 0.25 A; MPN KLZ1608MHR100WTD25
R15, R16: 10k; R_0603_1608Metric; Tolerance 0.1%; Voltage Rating 75 V; MPN MCT06030E1002BP100
R17: 330; R_0603_1608Metric; Tolerance 1%; Voltage Rating 75 V; MPN SR0603FR-7T330RL
R18: 1k; R_0603_1608Metric; Tolerance 0.1%; Voltage Rating 75 V; MPN MCT0603MD1001BP500
SW1: RESET; SW_SPST_EVQQ2; Voltage Rating 15 VDC, 250 VAC; Current Rating 20 mA; MPN EVQ-Q2Y03W
U5: SAMD51; TQFP-100_14x14mm_P0.5mm; MPN ATSAMD51N20A-AUT
U6: AT25DF041B-SSHN-T; SOIC-8_3.9x4.9mm_P1.27mm; Voltage Rating 1.65 - 3.6 V; MPN AT25DF041B-SSHN-T

Connections:
5V_EN: U5.40 (PC10)
5V_ISENSE: U5.15 (PB08)
8V_EN: U5.41 (PC11); also elsewhere on the board
8V_ISENSE: U5.16 (PB09); also elsewhere on the board
3959_EN: U5.43 (PC13)
3959_GOOD: U5.42 (PC12)
BOOST_EN: U5.57 (PC17); also elsewhere on the board
EN_IR_BUS: U5.44 (PC14); also elsewhere on the board
EN_TES_BUS: U5.56 (PC16)
FLASH_CS: R16.2, U5.28 (PA10), U6.1 (~CS), U6.3 (~WP~/IO2), U6.7 (~HOLD~/IO3)
FLASH_MISO: U5.29 (PA11), U6.2 (SO/IO1)
FLASH_MOSI: U5.26 (PA08), U6.5 (SI/IO0)
FLASH_SCK: U5.27 (PA09), U6.6 (SCK)
GND: C21.2, C22.2, C23.2, C24.2, C25.2, C26.2, C27.2, C28.2, C29.2, SW1.1, U5.11 (GNDANA), U5.24 (GND_1), U5.31 (GND_2), U5.38 (GND_3), U5.50 (GND_4), U5.62 (GND_5), U5.76 (GND_6), U5.90 (GND_7), U6.4 (GND); also elsewhere on the board
IO-CTS: U5.46 (PA12); also elsewhere on the board
IO-DCD: U5.52 (PA16); also elsewhere on the board
IO-DSR: U5.48 (PA14); also elsewhere on the board
IO-DTR: U5.32 (PB10); also elsewhere on the board
IO-RI: U5.66 (PB18); also elsewhere on the board
IO-RTS: U5.49 (PA15); also elsewhere on the board
IO-RX: U5.55 (PA19); also elsewhere on the board
IO-TX: U5.54 (PA18); also elsewhere on the board
MISO: U5.33 (PB11)
MODE_SW: C21.1, C22.1, C23.1, C24.1, C25.1, C26.1, R15.1, R16.1, R18.1, U5.12 (VDDANA), U5.39 (VDDIO_1), U5.51 (VDDIO_2), U5.63 (VDDIO_3), U5.77 (VDDIO_4), U5.92 (VDDIO_5), U6.8 (VCC); also elsewhere on the board
MOSI: U5.34 (PB12)
unnamed 78: R17.1, SW1.2; also elsewhere on the board
unnamed: U5.25 (VDDIOB_1), U5.30 (VDDIOB_2)
PWR_EN: U5.58 (PC18); also elsewhere on the board
PWR_SW: U5.59 (PC19)
RST: C29.1, R15.2, R17.2, U5.88 (RESETN); also elsewhere on the board
RX_LED: U5.100 (PB03); also elsewhere on the board
SCK: U5.35 (PB13)
SCL: U5.71 (PA21)
SDA: U5.70 (PA20)
SWCLK: R18.2, U5.93 (PA30); also elsewhere on the board
SWDIO: U5.94 (PA31); also elsewhere on the board
SWO: U5.85 (PC27)
SYS-RX: U5.79 (PB23); also elsewhere on the board
SYS-TX: U5.78 (PB22); also elsewhere on the board
TX_ACTIVE: U5.45 (PC15); also elsewhere on the board
TX_LED: U5.87 (PA27); also elsewhere on the board
USB_D+: U5.75 (PA25); also elsewhere on the board
USB_D-: U5.74 (PA24); also elsewhere on the board
VDDCORE: C27.1, C28.1, L2.1, U5.89 (VDDCORE)
VSW: L2.2, U5.91 (VSW)

Notes on the sheet:
Flash Memory
Reset Button
SWCLK Pullup
SAMD51 Power decoupling capacitors
SAMD51

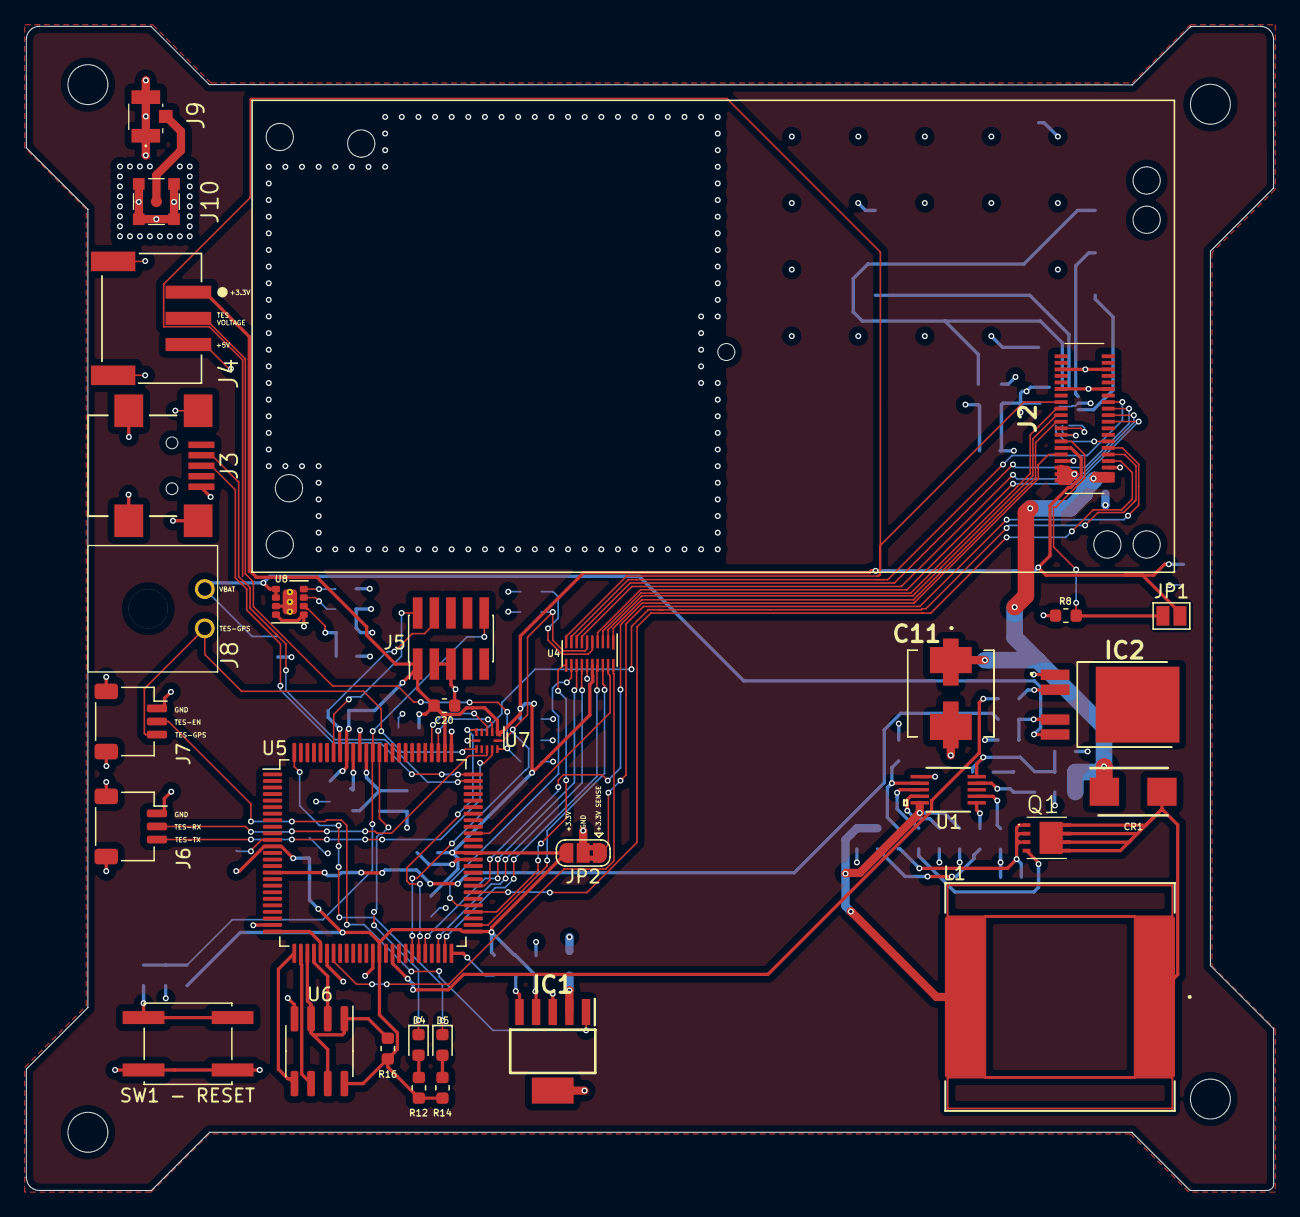
[picture p23: board Team-FIRE-v2.kicad_pcb from above]

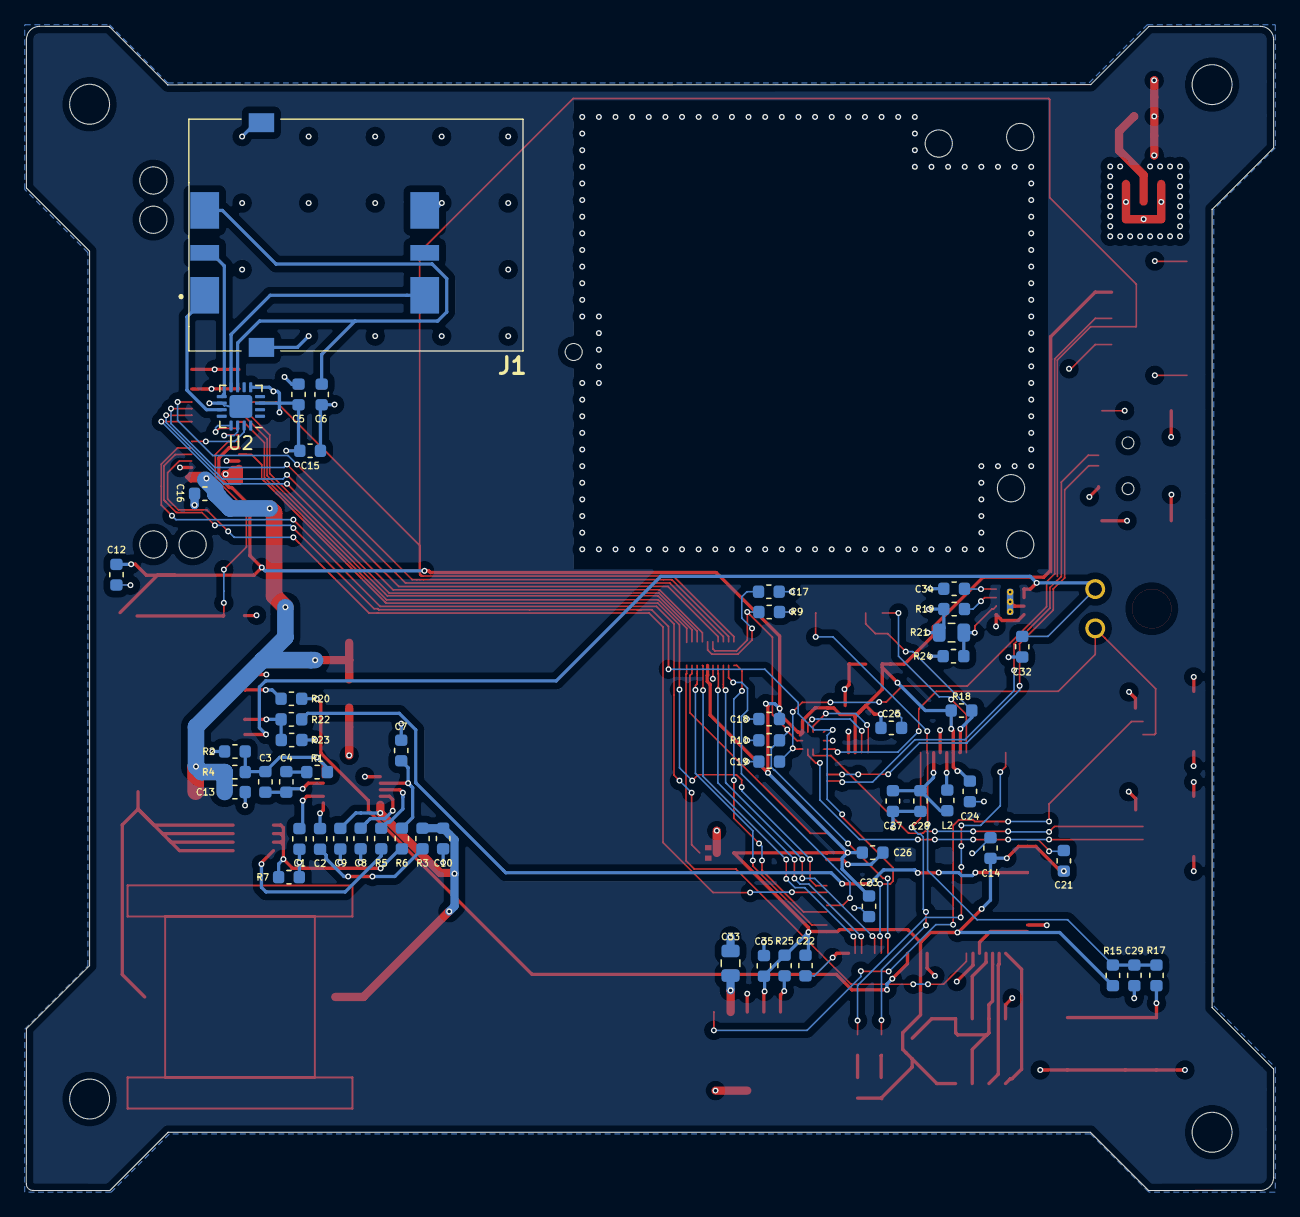
[picture p24: board Team-FIRE-v2.kicad_pcb from below]

Board: 4 copper layers, 95.3 x 88.9 mm, 84 parts (53 on the bottom side), 81 nets.

Other parts of the board:
SW1 - RESET: RESET; SW_SPST_EVQQ2

Their connections:
GND: SW1 - RESET.1; also elsewhere on the board
unnamed 78: SW1 - RESET.2; also elsewhere on the board
