CollinHeist/UIdaho-Team-FIRE/Component Test Board/Board v2.0/Board.kicad_pcb

## KiCad design Component Test Board/Board v2.0/Board.kicad_pcb (2020-05-07)

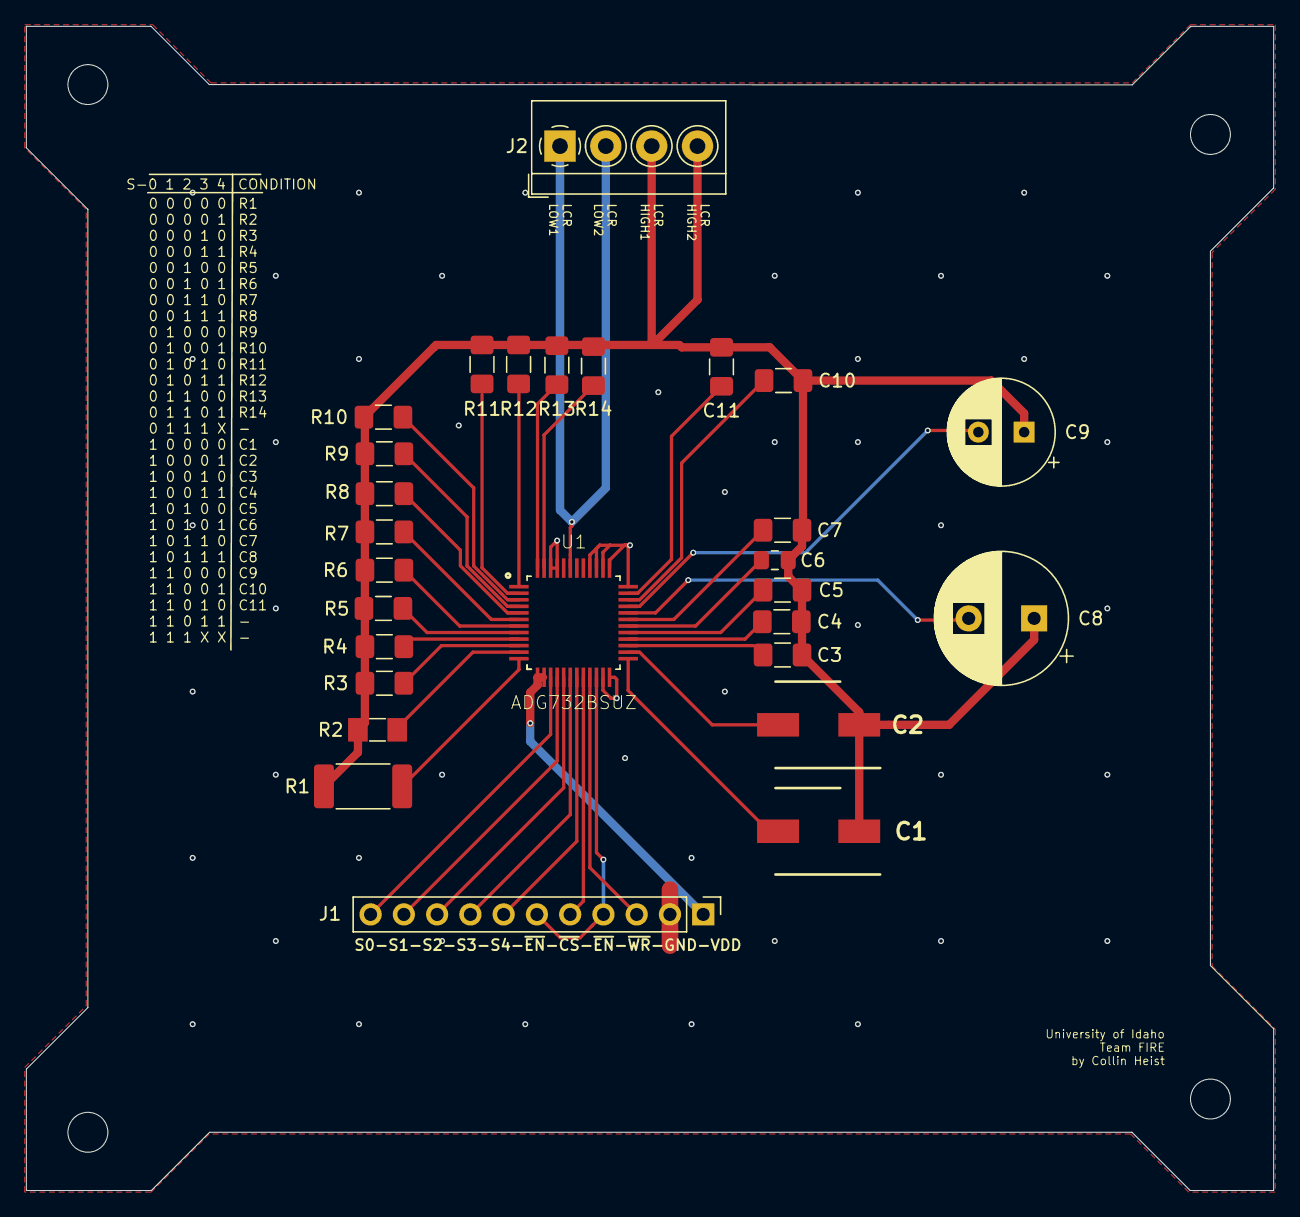
[picture p25: board Board.kicad_pcb from above]

Board: 2 copper layers, 95.2 x 88.9 mm, 28 parts (0 on the bottom side), 37 nets.

Parts:
C1, C2: 47u; CAPAE660X640N
C3, C4, C5, C7: 0.1u; C_1206_3216Metric_Pad1.42x1.75mm_HandSolder
C6: 0.1u; C_0805_2012Metric_Pad1.15x1.40mm_HandSolder
C8: 10; CP_Radial_D10.0mm_P5.00mm
C9: 2.2; CP_Radial_D8.0mm_P3.50mm
C10, C11: 47u; C_1206_3216Metric_Pad1.42x1.75mm_HandSolder
J1: Conn_01x11; PinHeader_1x11_P2.54mm_Vertical
J2: Screw_Terminal_01x04; TerminalBlock_4Ucon_1x04_P3.50mm_Horizontal
R1: 1.5k; R_2512_6332Metric_Pad1.52x3.35mm_HandSolder
R2: 1k; R_MiniMELF_MMA-0204
R3, R4, R5: 1k; R_1206_3216Metric_Pad1.42x1.75mm_HandSolder
R6: 20m; R_1206_3216Metric_Pad1.42x1.75mm_HandSolder
R7: 470m; R_1206_3216Metric_Pad1.42x1.75mm_HandSolder
R8: 100; R_1206_3216Metric_Pad1.42x1.75mm_HandSolder
R9, R10, R11, R12, R13, R14: 10k; R_1206_3216Metric_Pad1.42x1.75mm_HandSolder
U1: ADG732BSUZ; QFP50P900X900X120-49N

Connections:
GND: J1.2, U1.23, U1.24, U1.36, U1.37, U1.38, U1.39, U1.40, U1.45, U1.46
LCR_HIGH1: C1.1, C2.1, C3.1, C4.1, C5.1, C6.1, C7.1, C8.1, C9.1, C10.1, C11.1, J2.3, J2.4, R1.2, R2.2, R3.2, R4.2, R5.2, R6.2, R7.2, R8.2, R9.2, R10.2, R11.2, R12.2, R13.2, R14.2
LCR_LOW1: J2.1, J2.2, U1.43
unnamed: C1.2, U1.25
unnamed: C2.2, U1.26
unnamed: C3.2, U1.27
unnamed: C4.2, U1.28
unnamed: C5.2, U1.29
unnamed: C6.2, U1.30
unnamed: C7.2, U1.31
unnamed: C8.2, U1.32
unnamed: C9.2, U1.33
unnamed: C10.2, U1.34
unnamed: C11.2, U1.35
unnamed: R1.1, U1.12
unnamed: R2.1, U1.11
unnamed: R3.1, U1.10
unnamed: R4.1, U1.9
unnamed: R5.1, U1.8
unnamed: R6.1, U1.7
unnamed: R7.1, U1.6
unnamed: R8.1, U1.5
unnamed: R9.1, U1.4
unnamed: R10.1, U1.3
unnamed: R11.1, U1.2
unnamed: R12.1, U1.1
unnamed: R13.1, U1.48
unnamed: R14.1, U1.47
SELECT0: J1.11, U1.15
SELECT1: J1.10, U1.16
SELECT2: J1.9, U1.17
SELECT3: J1.8, U1.18
SELECT4: J1.7, U1.19
VDD: J1.1, U1.13, U1.14
~CS: J1.5, U1.20
~EN: J1.4, J1.6, U1.22
~WR: J1.3, U1.21
