CollinHeist/UIdaho-Team-FIRE/(commit log)

2020-04-28 Fix: connection of IO-RI
    [SAMD51_IO.sch, Team-FIRE-v2.sch, schematic-1.sch, schematic-2.sch, schematic-3.sch]
2020-04-28 Starting complete BOM generation
    - Finished schematic(s)
    - Started BOM information assignment for final BOM sent to NASA
    [Board.kicad_pcb, SAMD51_IO.sch, Team-FIRE-v2.sch, schematic-1.sch, schematic-2.sch, schematic-3.sch]
2020-04-29 Fixed libraries, added BOM info to most components
    - Fixed MCP1826T library to be a part of Team-Fire library (not separate)
    - Deleted useless library files for various pieces (such as ImportGuides, etc.)
    - Fixed inductor value specification for boost converter
    [MCP1826T-3302E_DC.stp, SAMD51_IO.sch, schematic-1.sch, schematic-2.sch, schematic-3.sch]
2020-04-29 Added EEE-FK1H390SV
    - Created EEE-FK1H390SV symbol and footprint
    - Added EEE-FK1H390SV to Team-FIRE libraries
    - Added EEE-FK1H390SV to 8 to 30V boost circuit
    [schematic-1.sch]
2020-04-29 Finished component selection for Bus Translators
    - Finished filling out all details for every component in Bus Translator block
    - Annotated existing schematic
    [schematic-2.sch]
2020-04-30 Made a lot of changes...
    - Added symbol, footprint for Micro USB B connector
    - Fixed Flash Memory schematic
    - Added details for many components
    [SAMD51_IO.sch, UX60-MB-5ST.stl, UX60-MB-5ST.stp, schematic-1.sch, schematic-2.sch, schematic-3.sch]
2020-04-30 fixed issue
    [SAMD51_IO.sch, schematic-2.sch]
2020-04-30 Fixed some stuff (woops)
    [SAMD51_IO.sch, UX60-MB-5ST.stl, schematic-2.sch]
2020-04-30 Fixed alignment(s), added component details
    [SAMD51_IO.sch, schematic-3.sch]
2020-04-30 Labelled finished sections on schematic, picked LEDs
    - Labelled all finished schematic sections if they've been part-selected / verified (and by whom)
    - Selected the four debug LEDs and filled out BOM info
    - Filled out info for Power/TES connectors
    - Filled out info for RF connector
    - Filled out info for 5 to 3.3V regulator
    - Filled out info for 8 to 5V switching regulator
    - Assigned footprints to test points
    [SAMD51_IO.sch, schematic-1.sch, schematic-2.sch, schematic-3.sch]
2020-05-01 Selected components for SAMD51
    - Selected components for crystal oscillators
    - Selected component for reset button
    - Selected component for flash memory (cant find details for flash module...)
    - Ran schematic annotation
    [SAMD51_IO.sch]
2020-05-01 30V net for boost
    [SAMD51_IO.sch, Team-FIRE-v2.sch, schematic-1.sch, schematic-2.sch, schematic-3.sch]
2020-05-01 annotated stuffff
    [SAMD51_IO.sch, schematic-2.sch, schematic-3.sch]
2020-05-01 Fix positioning of SAMD51
    [SAMD51_IO.sch, Team-FIRE-v2.sch, schematic-1.sch, schematic-2.sch, schematic-3.sch]
2020-05-01 Fix: issues with merge
    [SAMD51_IO.sch]
2020-05-05 Minor changes..
    [Team-FIRE-v2.sch, schematic-1.sch, schematic-2.sch, schematic-3.sch]
2020-05-06 Finished SAMD part selection, fixed alignment on all sheets
    - Fixed part selection for all SAMD51 sheet components
    - Fixed grid misalignment in SAMD51 components
    - Had to remove all SAMD51 additional text for this fix
    - Added no connects to unused pins for SAMD51
    - Removed component selection comments for all pages
    - Add components selected except one or two boost circuit components and the SIM card connector.
    [SAMD51_IO.sch, schematic-1.sch, schematic-2.sch, schematic-3.sch]
2020-05-06 minor aesthetic change
    [SAMD51_IO.sch]
2020-05-06 Added footprints (& potential one for SIM)
    [SAMD51_IO.sch, Team-FIRE-v2.sch, schematic-1.sch, schematic-2.sch, schematic-3.sch]
2020-05-06 Fixed some library problems
    - Deleted uselss import files
    - Fixed B26013F library files
    - Fixed IHLP6767GZER220M11 library files
    - Fixed weird library reference for inductor, transistor, and diode
    - Imported shelby's files to the Team-FIRE library
    [SAMD51_IO.sch, Team-FIRE-v2.sch, schematic-1.sch, schematic-2.sch, schematic-3.sch]
2020-05-06 Finished schematic
    - Added 47338-2001 symbol, footprint, and model to schematic
    - Added 47338-2001 to Team-FIRE library
    - Created custom SIM card holder symbol
    - Added all component description values for SIM card holder
    [47388-2001.stp, schematic-1.sch]
2020-05-06 Replaced transistor symbol, and footprint
    - Had to replace the CSD18543Q3AT transistor with a custom symbol, footprint and 3D model to account for the 9-pin package it resides in (not a 3 pin as the symbol depicts)
    [B260-13-F.stp, CSD18543Q3AT.stp, Team-FIRE-v2.kicad_pcb, schematic-1.sch, schematic-2.sch, schematic-3.sch]
2020-05-06 Fixed flash memory symbol assignment, generated final netlist
    - Symbol for Flash unit was a reference to a DSSOP package, and thus had the wrong pin names for that footprint; updated the symbol to reflect the correct footprint
    - Generated new netlist based on complete schematic, added all symbols to the PCB file
    [SAMD51_IO.sch, Team-FIRE-v2.kicad_pcb]
2020-05-06 Did some preliminary PCB work
    - Started the PCB layout
    - Put connectors in their probable spots
    [Team-FIRE-v2.kicad_pcb]
2020-05-07 Finished PCB
    - Added various 3D models for a complete 3D visualization of the PCB
    - Generated a finalized netlist
    - Fixed misnamed net from IR_SIM_RST to IR_SIM_RESET
    - Finished all component placement for the PCB; the only work remaining are the mounting holes, and the grounding vias for the IRIDIUM
    [FTSH-105-01-L-DV-K-TR.stp, IHLP6767GZER220M11.stl, IHLP6767GZER220M11.stp, S3B-PH-SM4-TB(LF)(SN).STEP, SAMD51_IO.sch, SM03B-SRSS-TB_LF__SN_.stp, TPS40210DGQR.stp, Team-FIRE-v2.kicad_pcb]
2020-05-07 Minor changes
    - Made some little changes; not really important.
    [393570004.stp, Board.kicad_pcb, Team-FIRE-v2-BOM.csv, schematic-1.sch]
2020-05-07 Moved stuff
    [SAMD51_IO.sch, Team-FIRE-v2.kicad_pcb, schematic-3.sch]
2020-05-07 Increased trace width for boost circuitry & added silk screen
    [Team-FIRE-v2.kicad_pcb]
2020-05-10 Deleted unused LED's, finished mounting for IRIDIUM
    - Delete the two unused LEDs from schematic and layout
    - Added grounding vias for antenna connection
    - Added grounding vias for IRIDIUM 9523 modem
    - Added keepout zones (except GND) for antenna and modem
    [Team-FIRE-v2.kicad_pcb, schematic-2.sch]
2020-05-27 Moved some stuff
    [Team-FIRE-v2.kicad_pcb]
